dmitryshagin/flashlight/drawings/c_1/page1.png

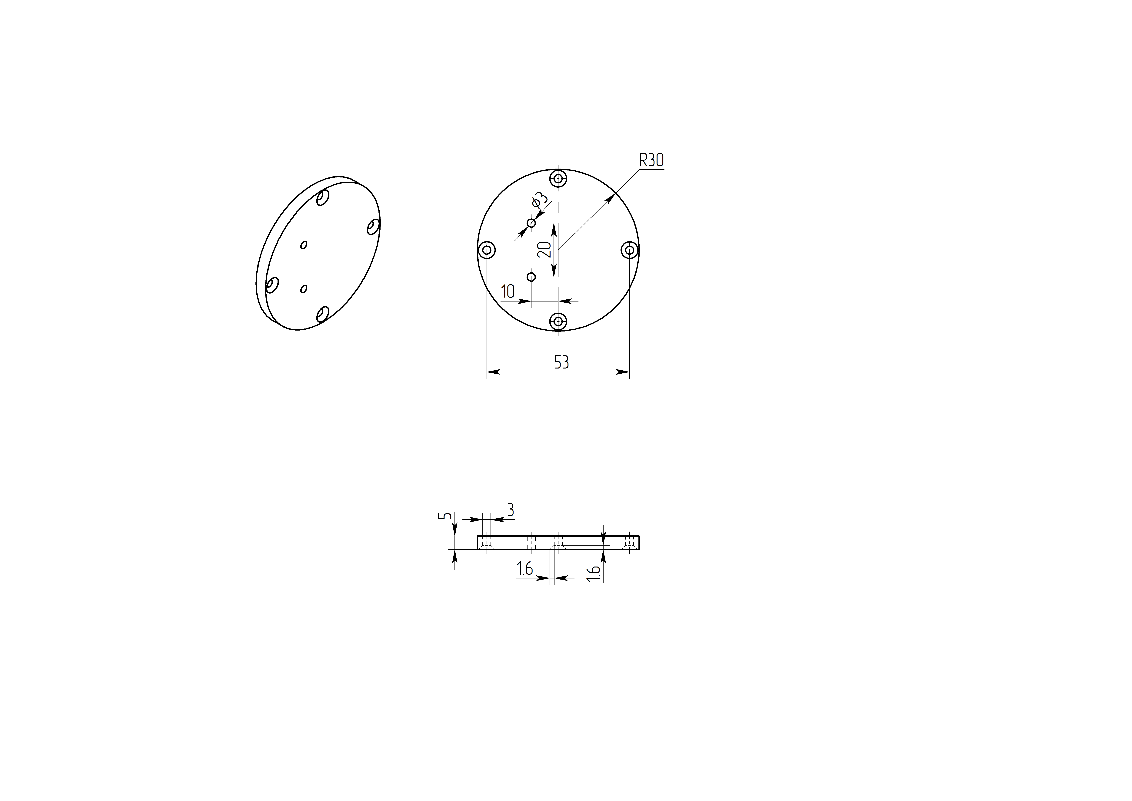
drawings/c_1/page1.png
