dmitryshagin/flashlight/drawings/c_1/page2.png

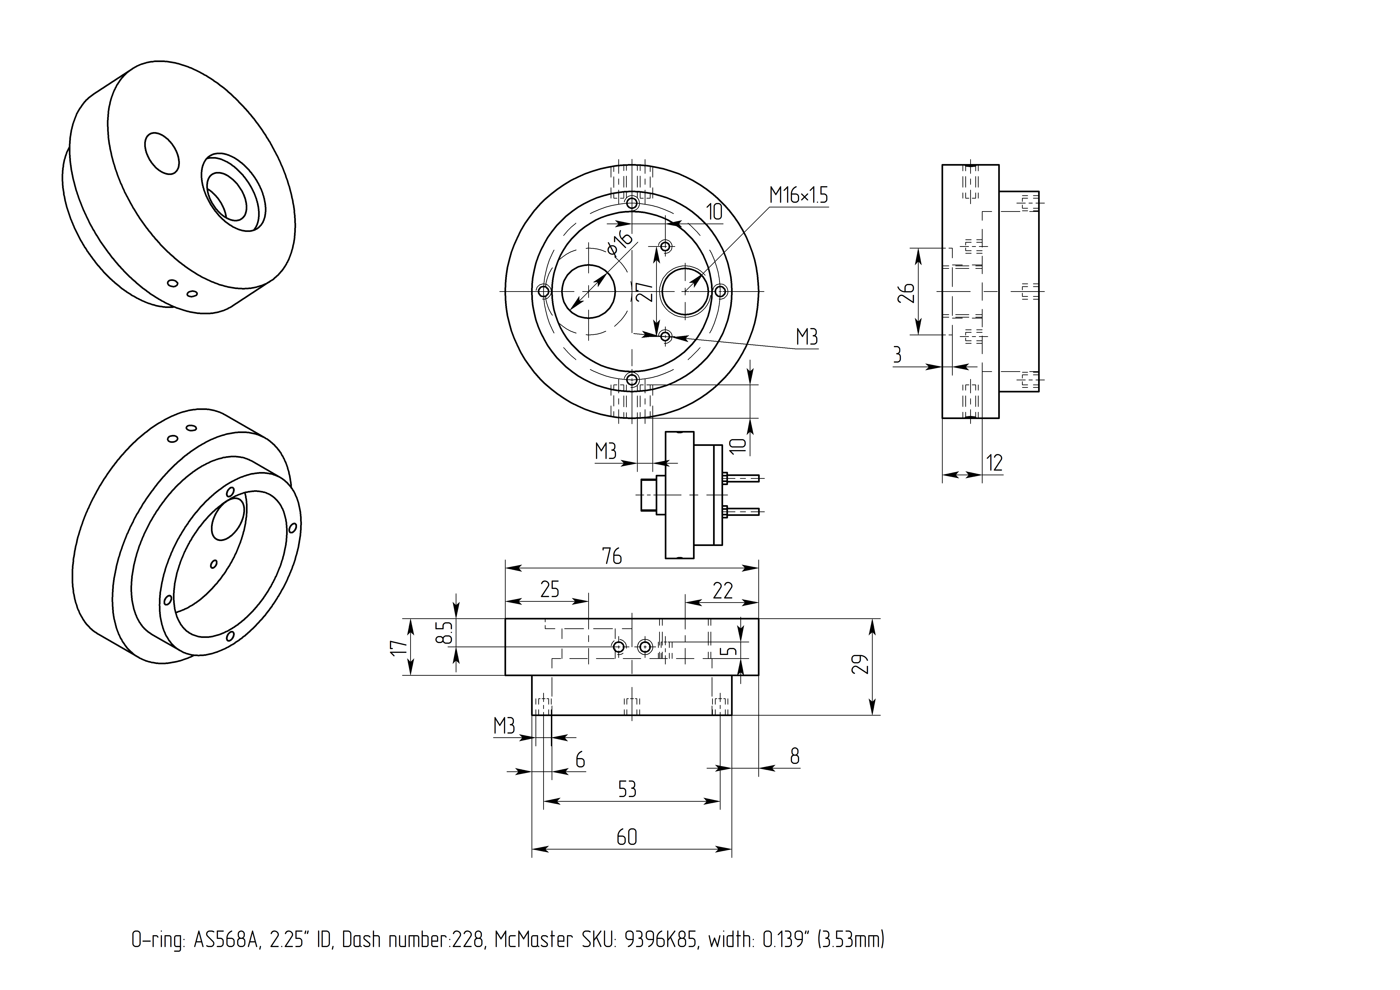
drawings/c_1/page2.png
