dmitryshagin/flashlight/drawings/c_1/page3.png

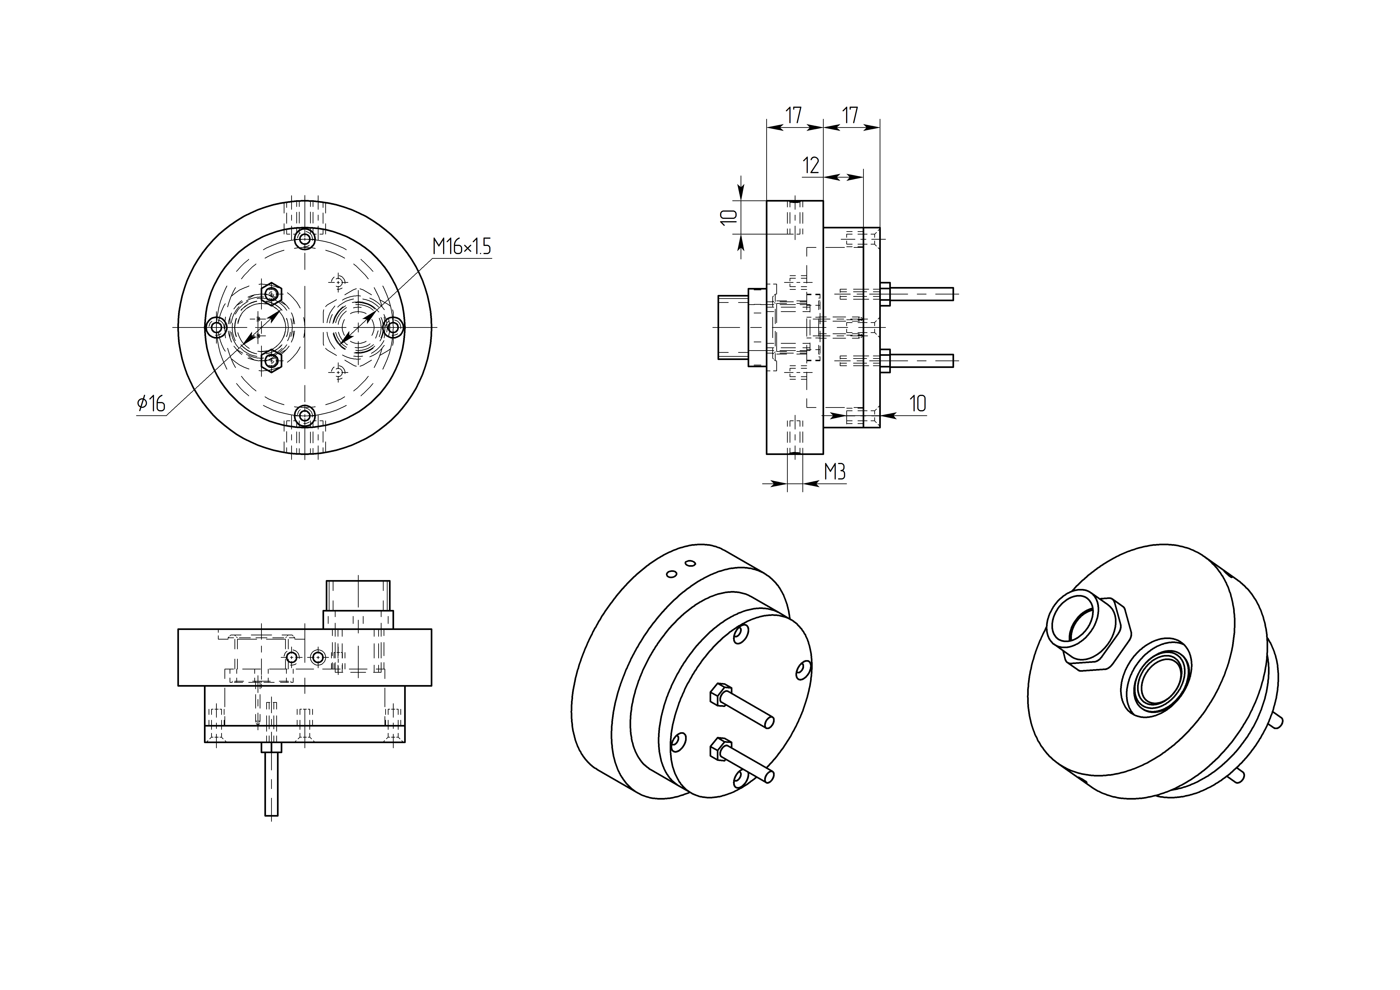
drawings/c_1/page3.png
