dmitryshagin/flashlight/drawings/c_1/page4.png

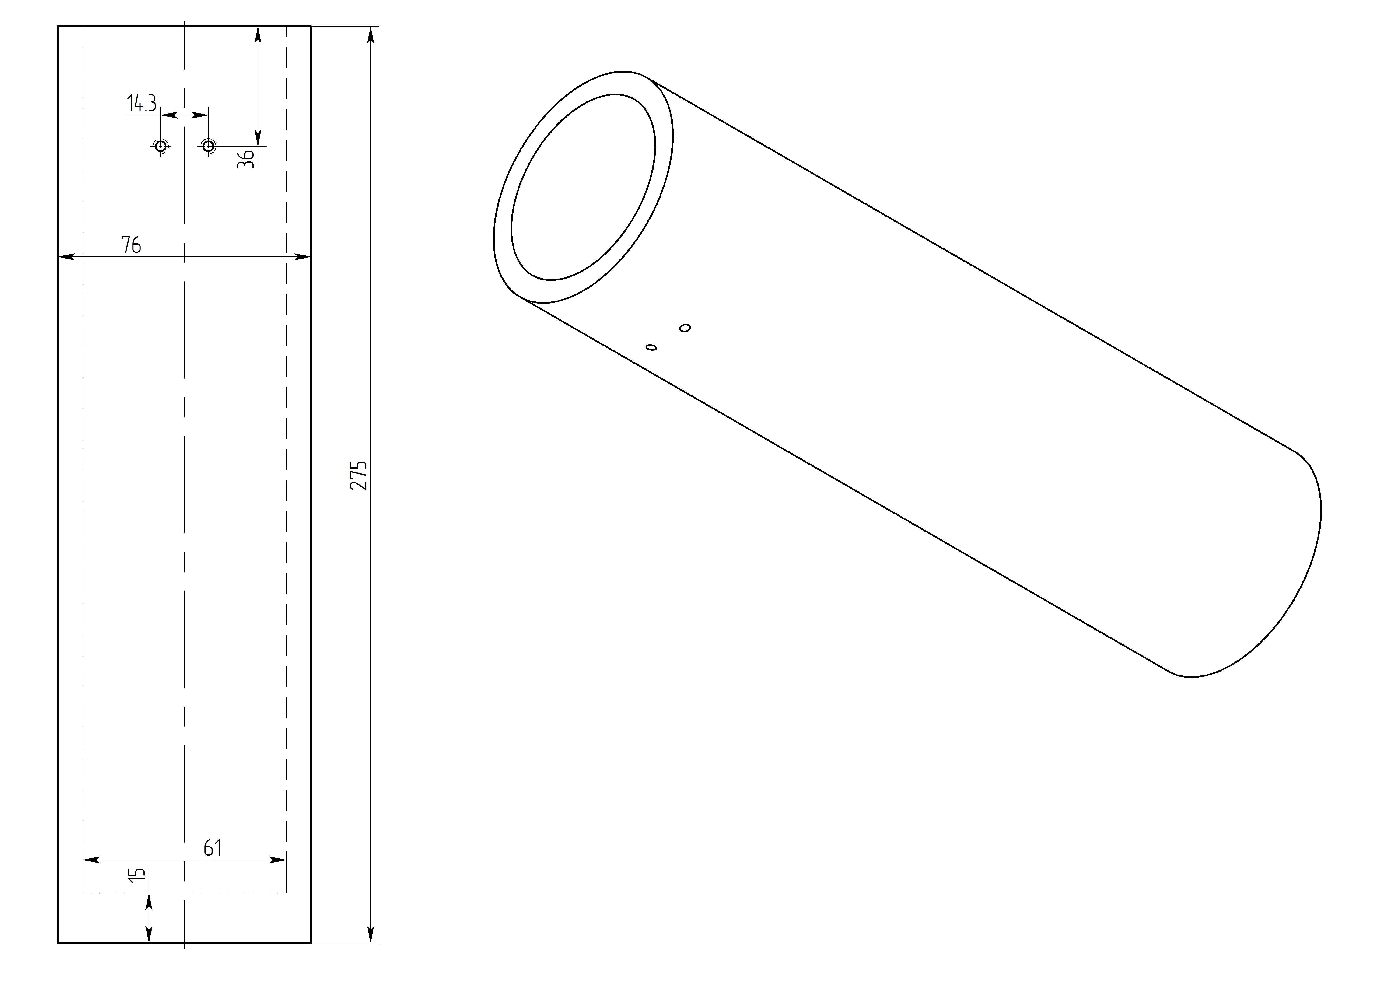
drawings/c_1/page4.png
