dmitryshagin/flashlight/drawings/c_1/page5.png

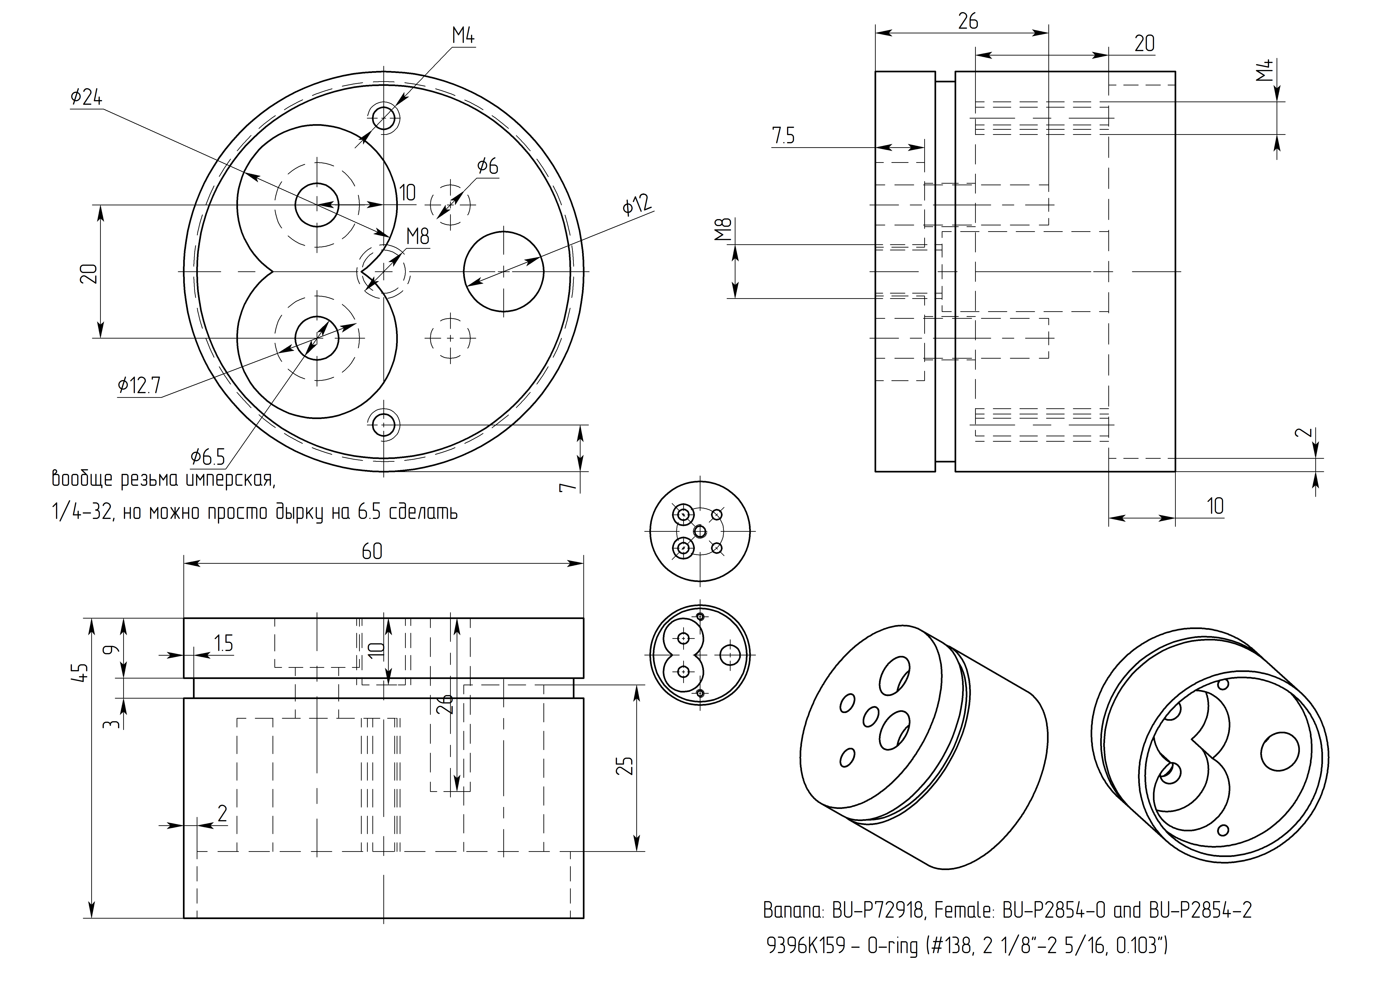
drawings/c_1/page5.png
