dmitryshagin/flashlight/drawings/c_1/page6.png

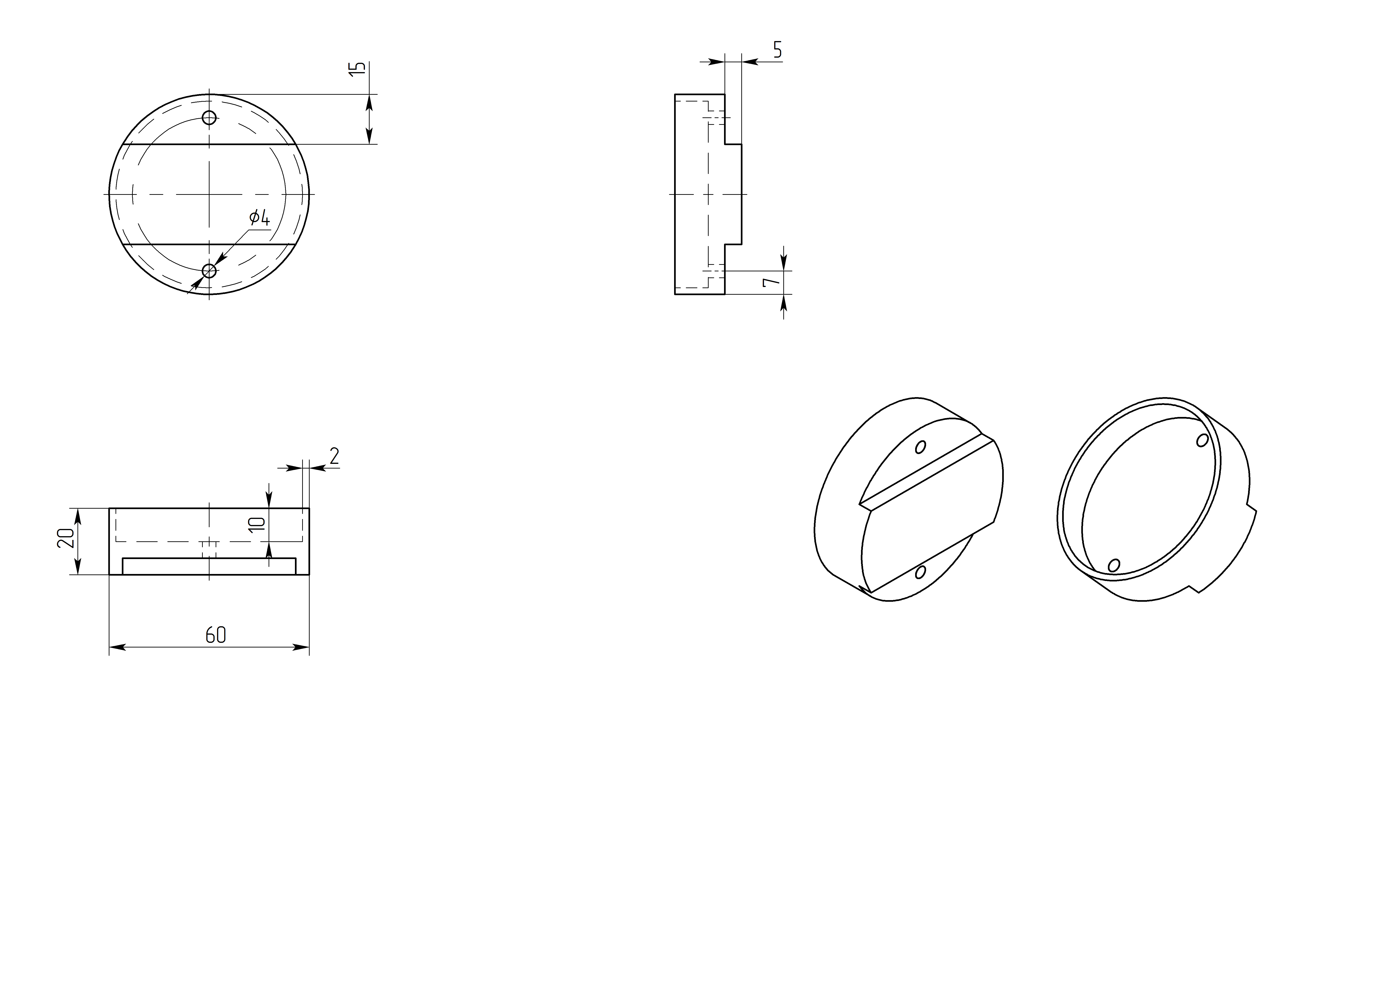
drawings/c_1/page6.png
