dmitryshagin/flashlight/drawings/c_1/page7.png

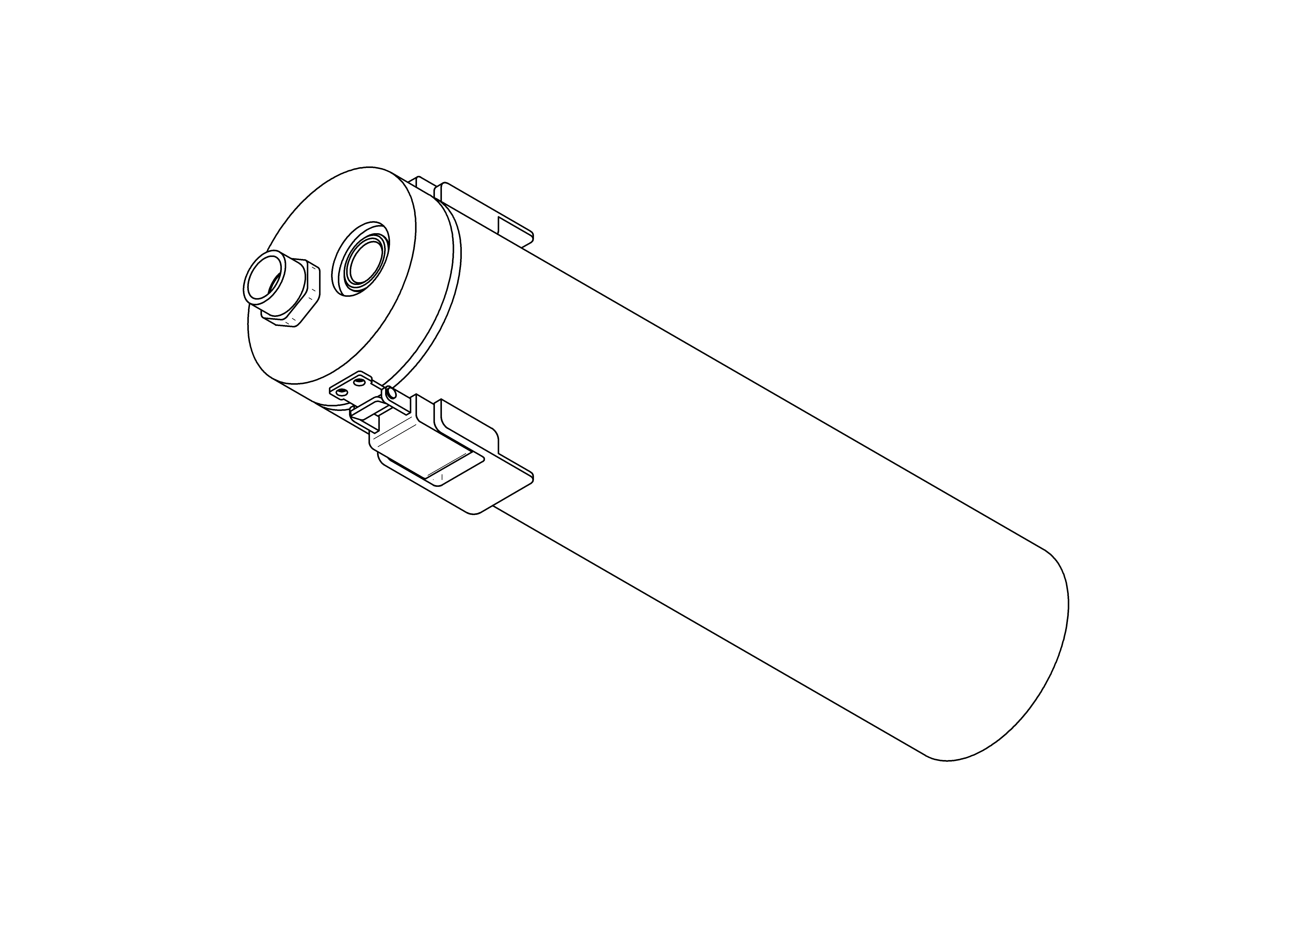
drawings/c_1/page7.png
