dmitryshagin/flashlight/drawings/c_1/page8.png

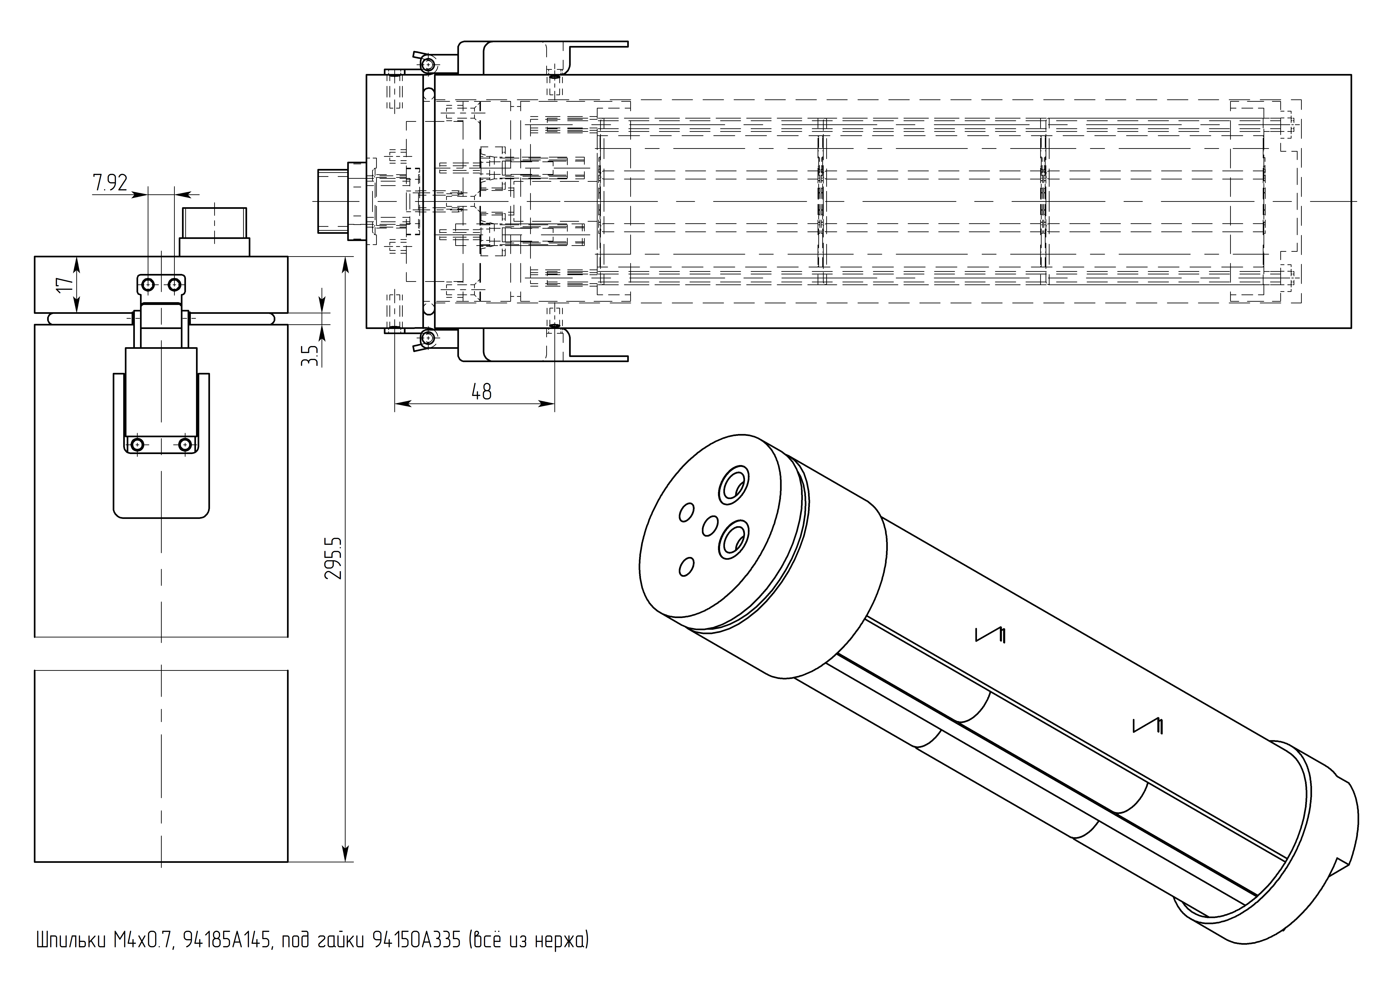
drawings/c_1/page8.png
