dmitryshagin/flashlight/drawings/c_1/page9.png

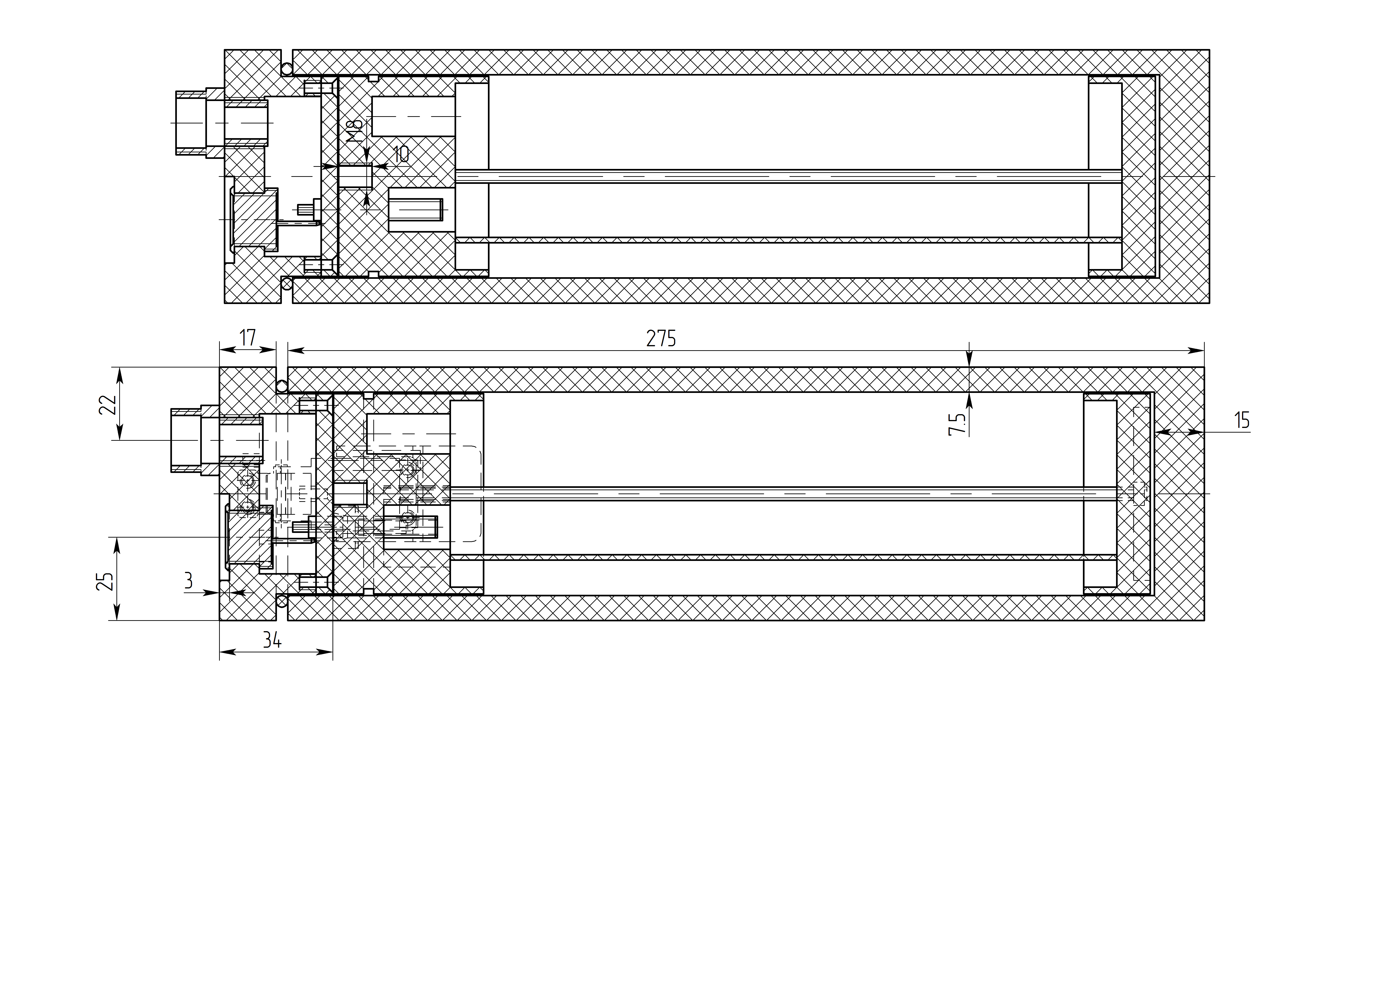
drawings/c_1/page9.png
