dmitryshagin/flashlight/drawings/v_1_2/page1.png

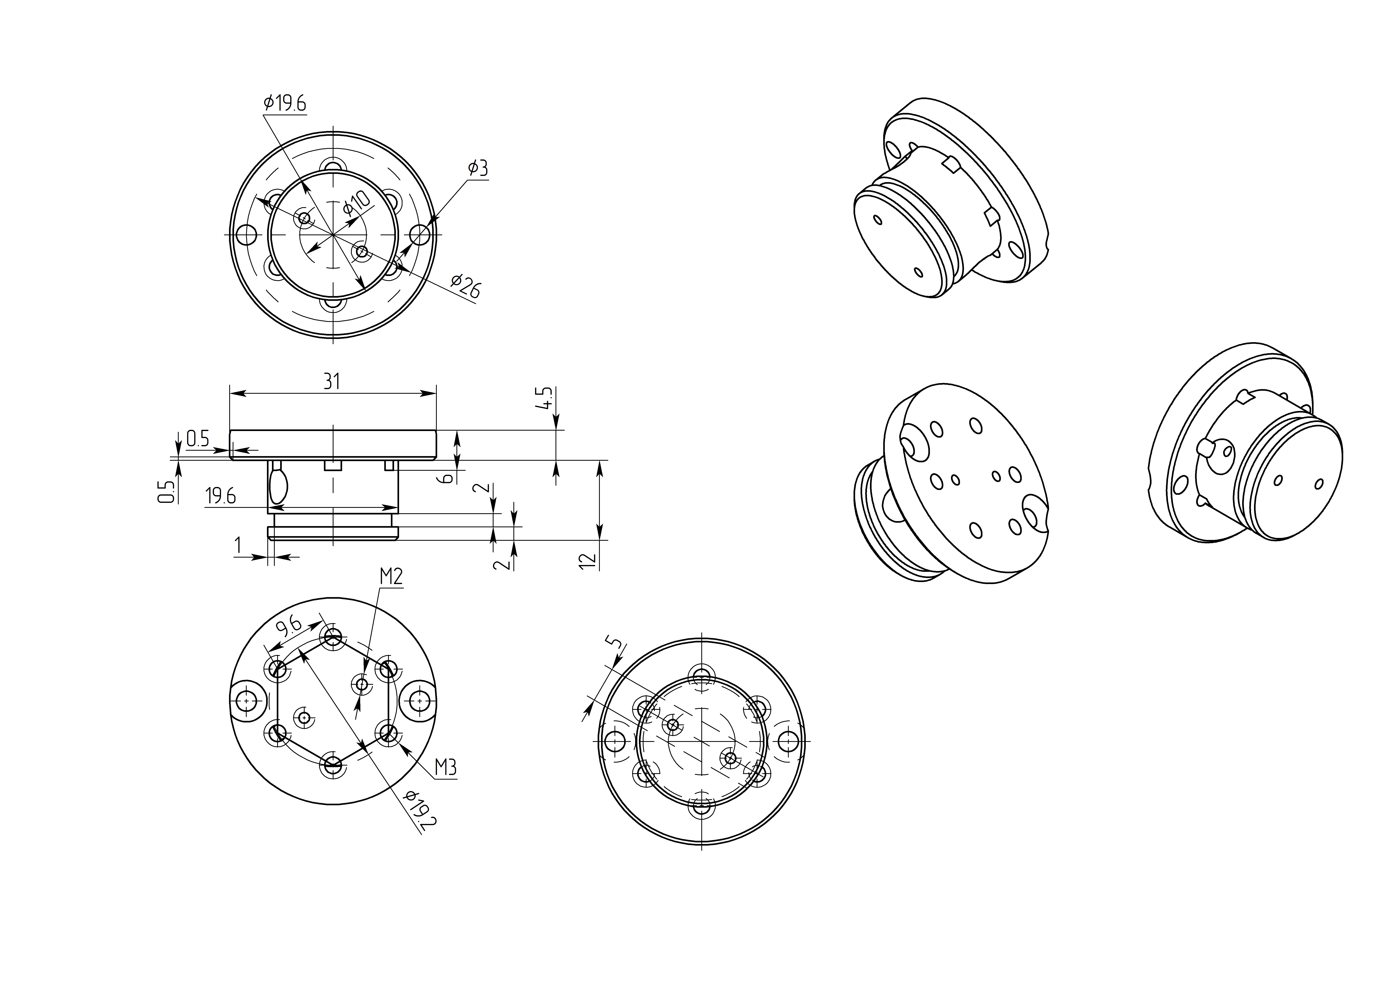
drawings/v_1_2/page1.png
