dmitryshagin/flashlight/drawings/v_1_2/page4.png

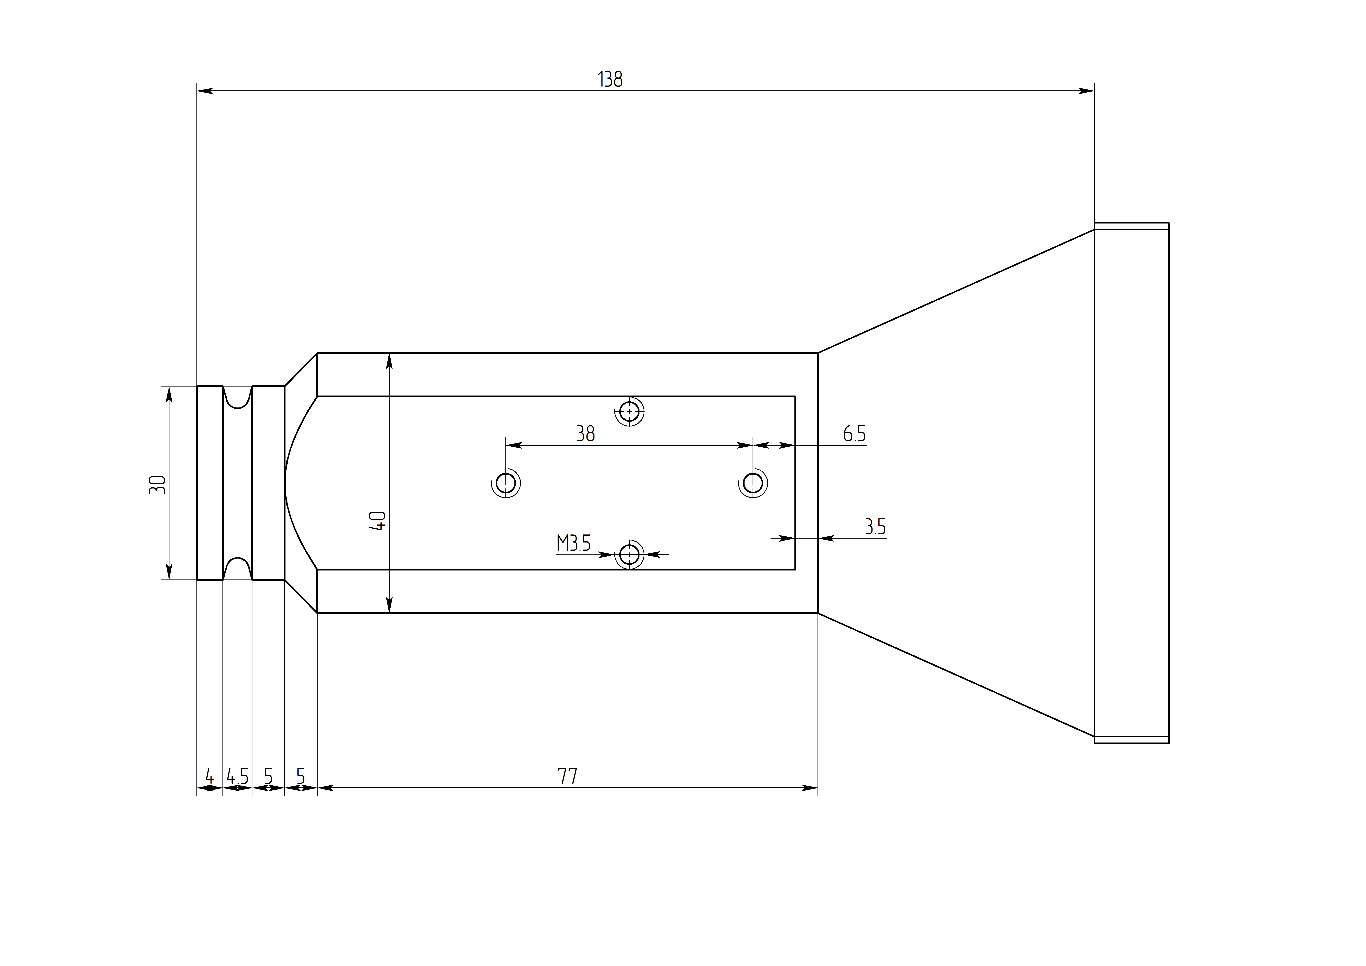
drawings/v_1_2/page4.png
