dmitryshagin/flashlight/drawings/v_1_2/page5.png

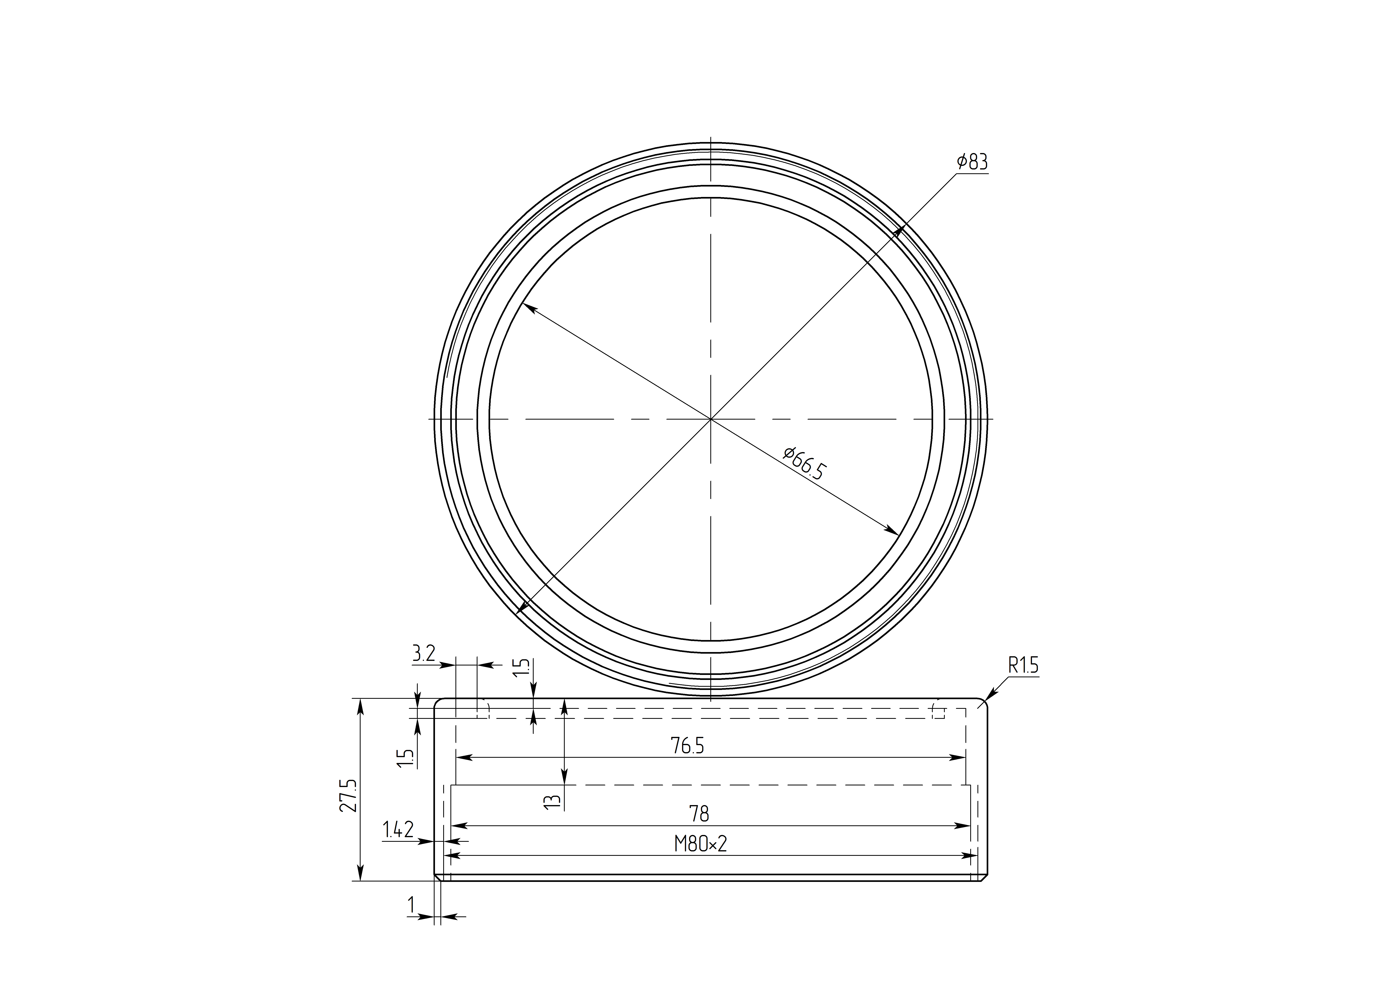
drawings/v_1_2/page5.png
