dmitryshagin/flashlight/drawings/v_1_2/page6.png

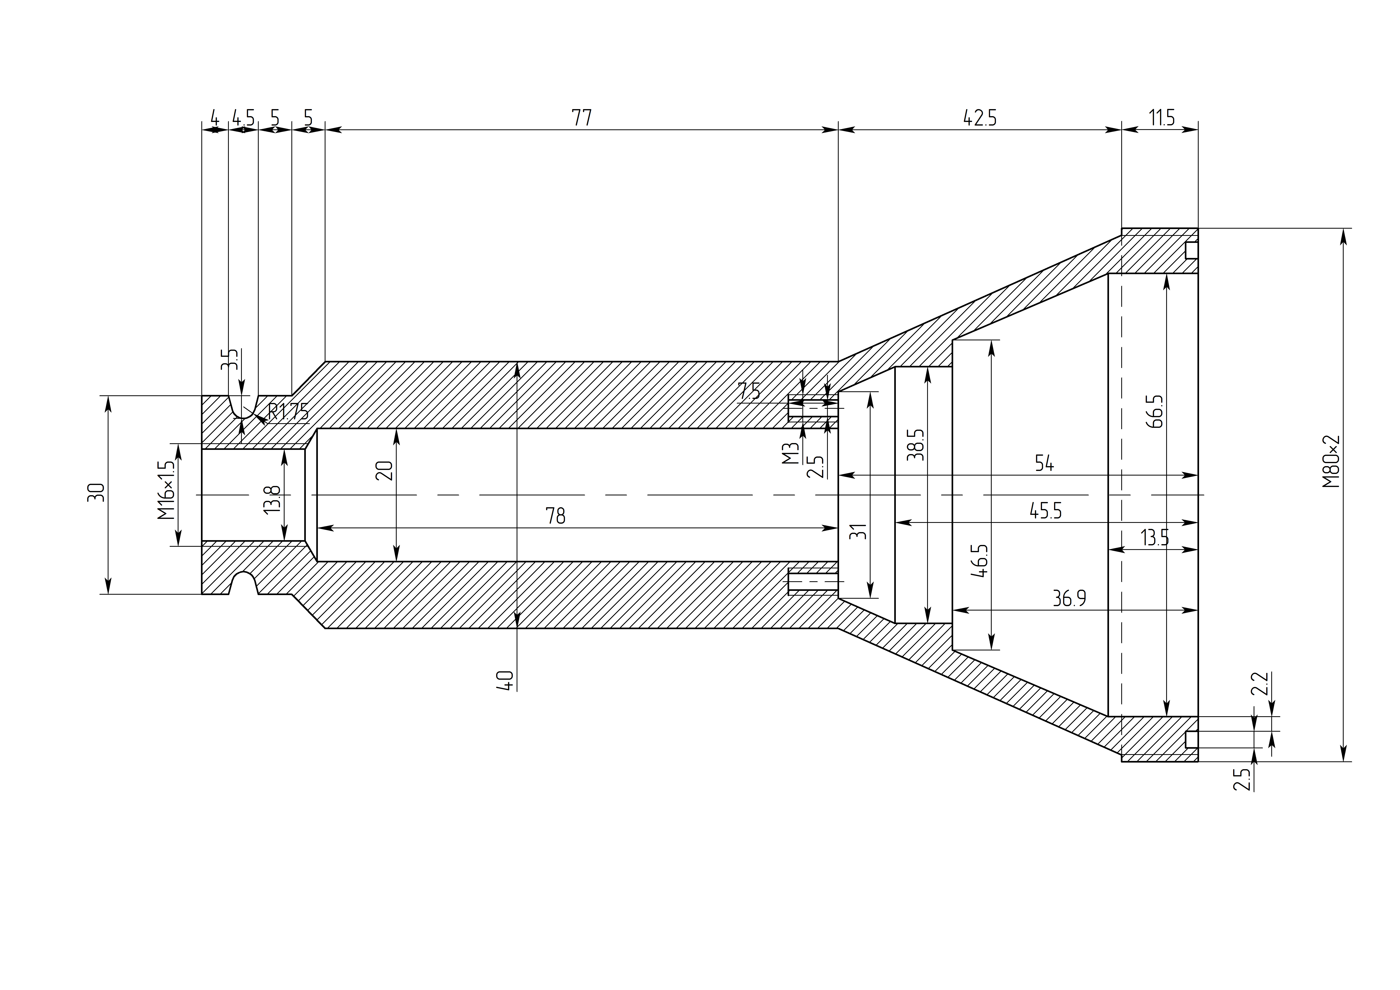
drawings/v_1_2/page6.png
