dmitryshagin/flashlight/drawings/v_1_2/page7.png

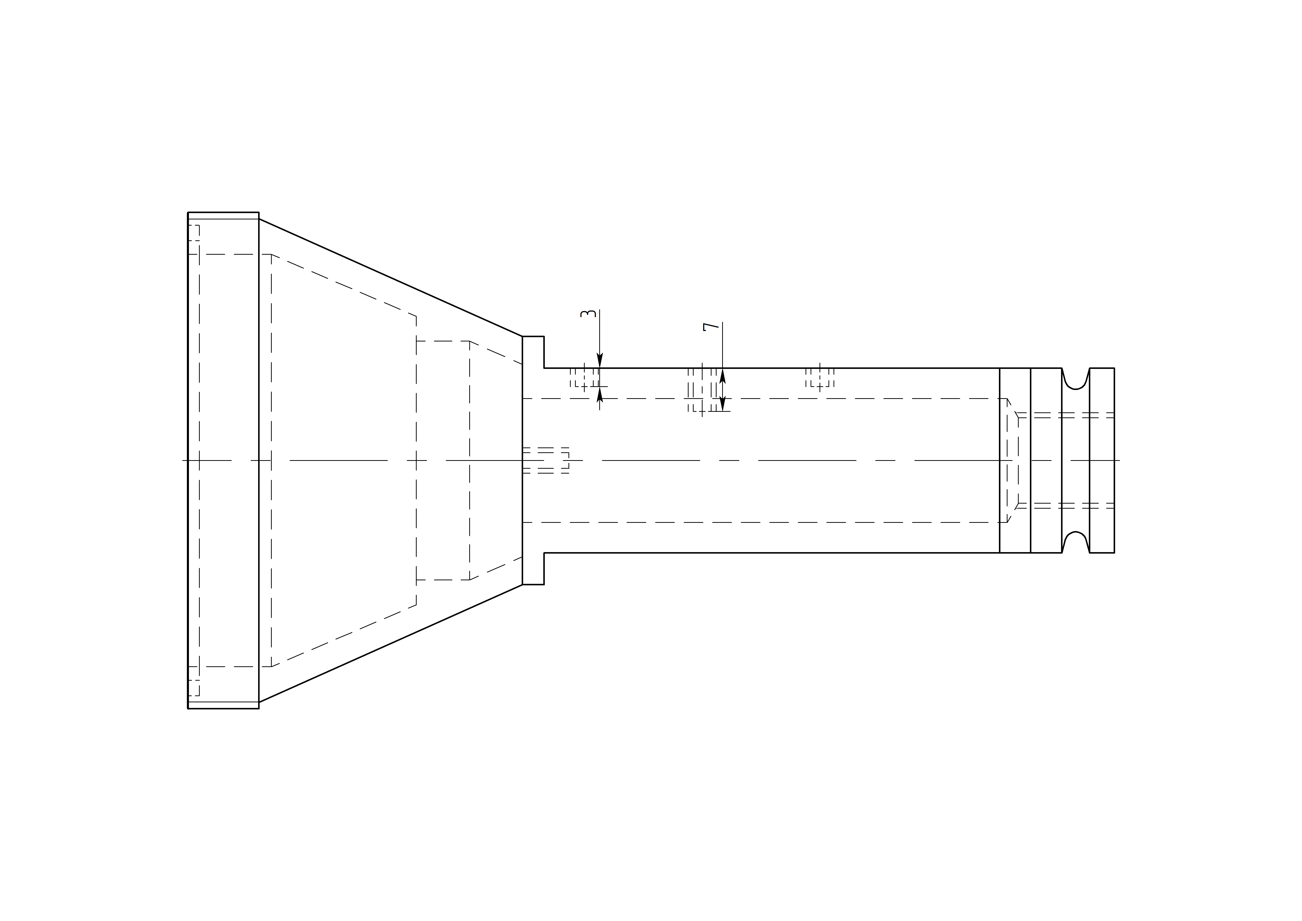
drawings/v_1_2/page7.png
