dmitryshagin/flashlight/drawings/v_1_2/page8.png

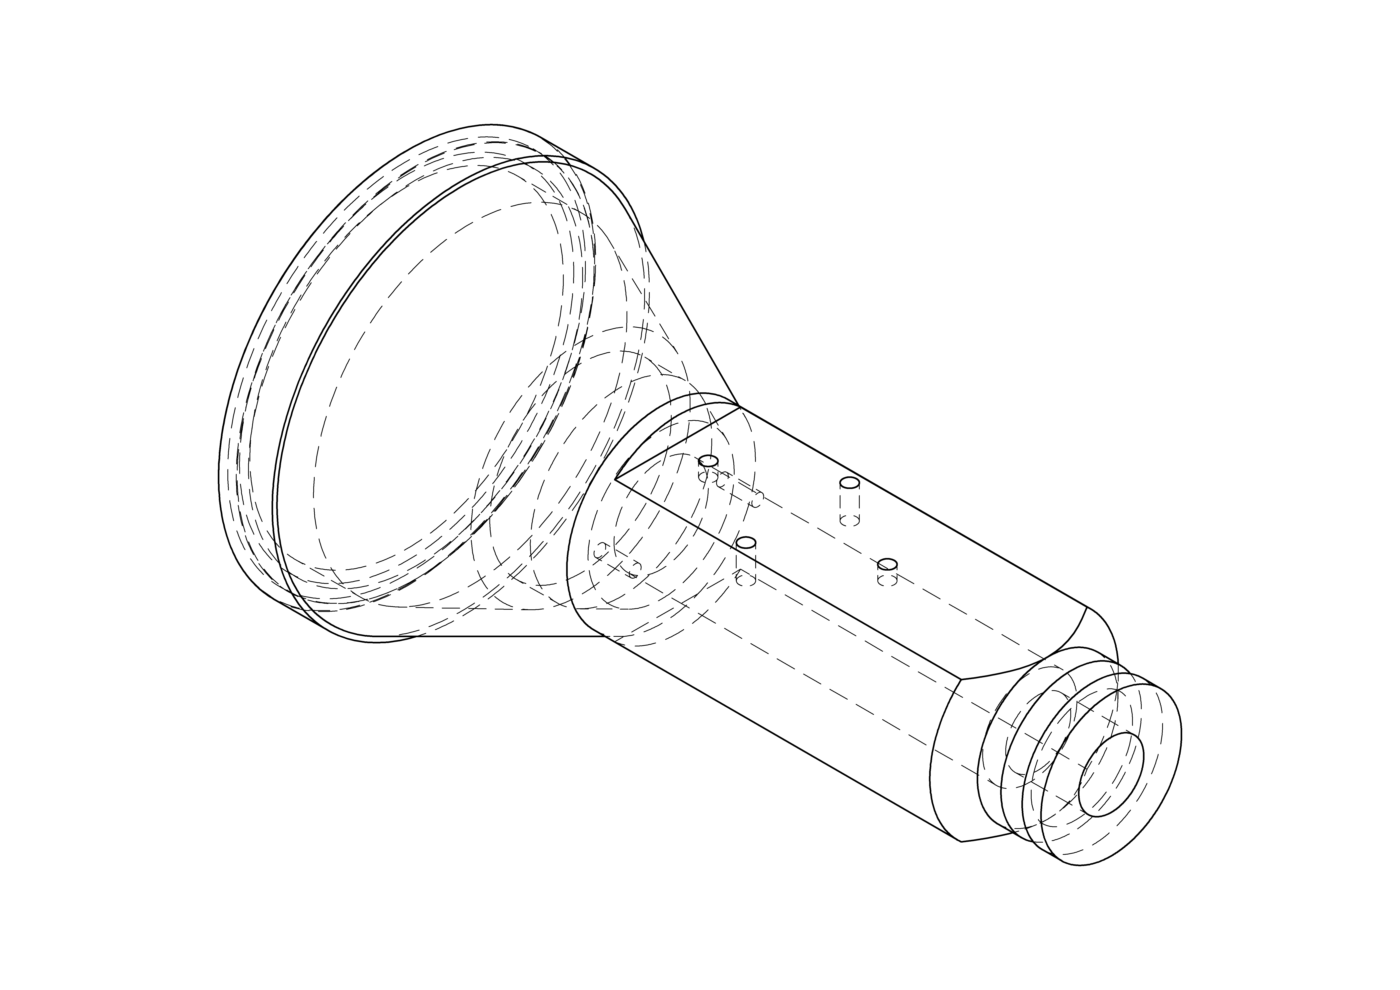
drawings/v_1_2/page8.png
