dmitryshagin/flashlight/drawings/v_1_2/page9.png

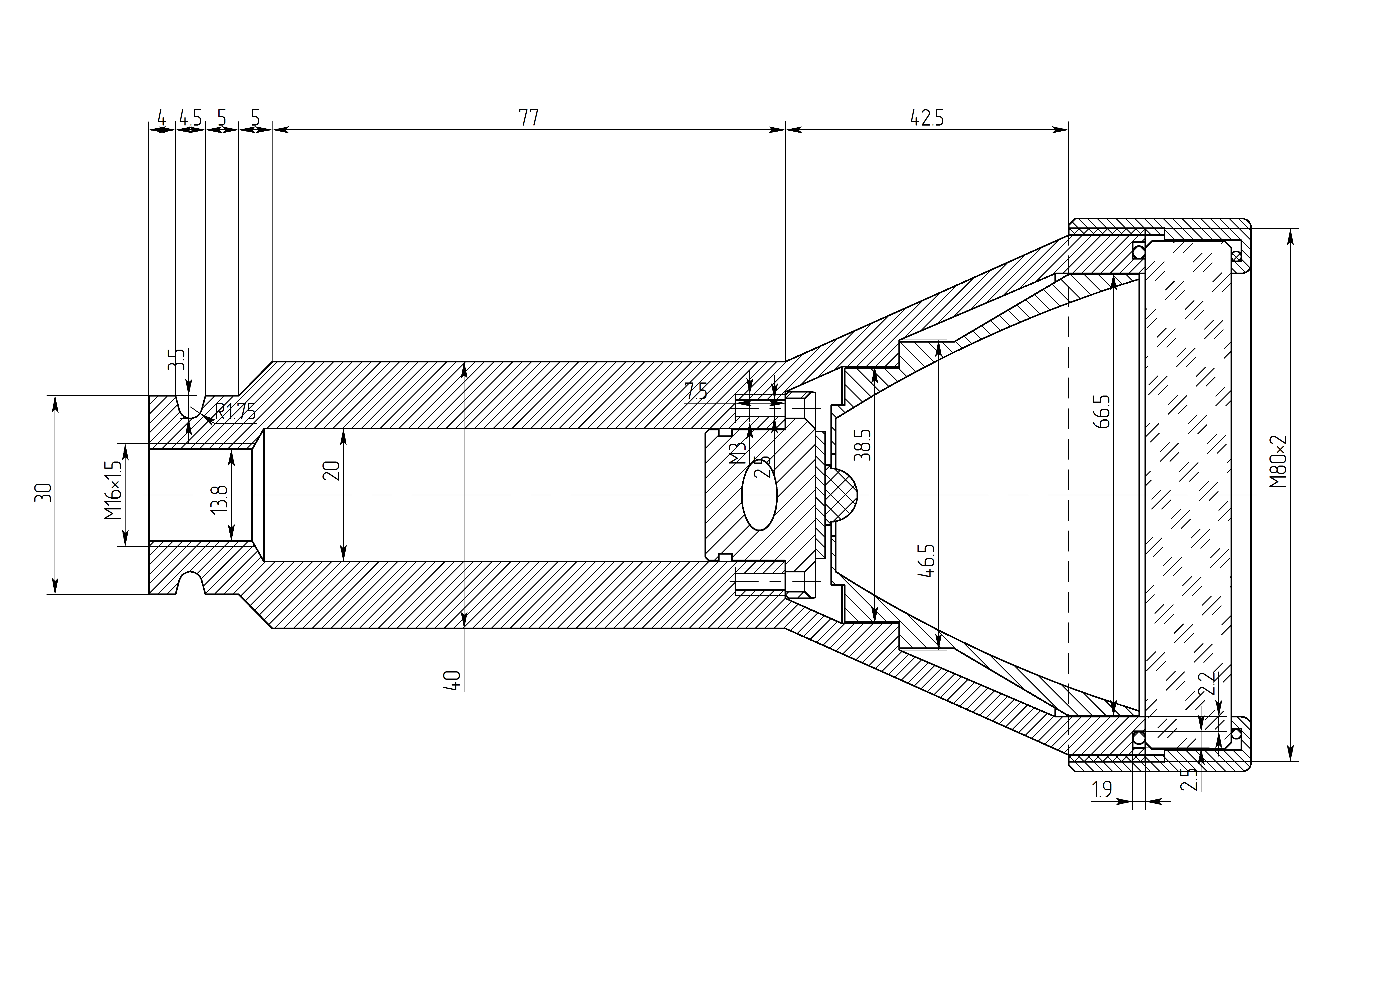
drawings/v_1_2/page9.png
