dmitryshagin/flashlight/drawings/c_1/Сглаживание_1.stl

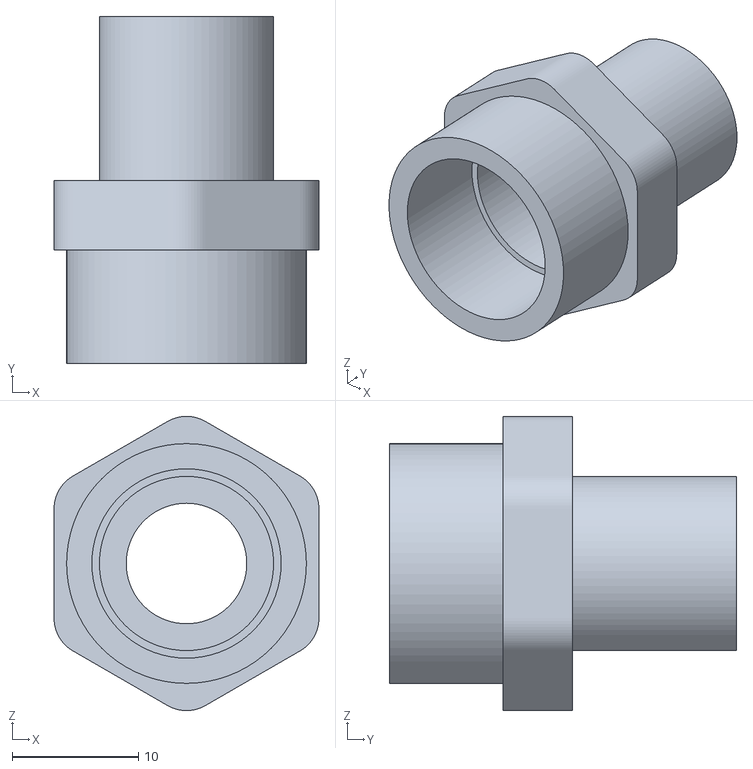
[picture p17: CAD file, 2018-02-22]
drawings/c_1/Сглаживание_1.stl
21.0 x 27.5 x 23.3
