dmitryshagin/flashlight/(list of files, cad)

Other CAD files:
Head.3dm
drawings/c_1/Сглаживание_1.x_t
