dmitryshagin/flashlight/LT3763_TA01_2led.asc

C1: cap; .01µ
C3: cap; 33n
C4: cap; 2.2µ; V=10 Irms=0 Rser=0.002 Lser=0 mfg="TDK" pn="C2012X5RIA225K" type="X5R"
C6: cap; 10µ; V=25 Irms=0 Rser=0.001 Lser=0 mfg="TDK" pn="C575OX7RIE106M" type="X7R"
C7: cap; 4.7µ; V=10 Irms=0 Rser=0.003 Lser=0 mfg="TDK" pn="C3216X5RlA475M" type="X5R"
C8: cap; .22µ
C9: cap; 4.7n
C10: polcap; 220µ; x2; V=10 Irms=6.5 Rser=0.006 Lser=0 mfg="KEMET" pn="T530D227M010ASE006" type="Tantalum"
C11: cap; 1µ; V=25 Irms=0 Rser=0.007 Lser=0 mfg="TDK" pn="C3216X7RIE105M" type="X7R"
D1: schottky; ZLLS2000
D2: LED; PT-121-B
D3: LED; PT-121-B
L1: ind; 2µ; Ipk=24 Rser=0.0028 Rpar=0 Cpar=0 mfg="Pulse" pn="PG0077.202"
Q1: nmos; BSZ0901NSI
Q2: nmos; BSZ0904NSI
R1: res; 82K
R2: res; 10
R3: res; 10
R5: res; 54.9K
R6: res; 110K
R9: res; 15m
R10: res; 54.9K
R11: res; 10K
R13: res; 54.9K
U1: LT3763
V2: voltage; 15
Named nets: 0, IN, OUT
.tran 0 10m 0.1m steady nodiscard uic
LT3763 10W  Single LED Driver
Input: 5V to 20V    Outputs: Cree XM-L2
