dmitryshagin/flashlight/(list of files, drawings)

Other design files:
button_control/control.dsn
driver/led_driver_3A.dsn
driver/led_driver_3A_flat.dsn
