dmitryshagin/flashlight/button_control_esp32/button_control_esp32.brd

## EAGLE design button_control_esp32/button_control_esp32.brd (2019-01-24)

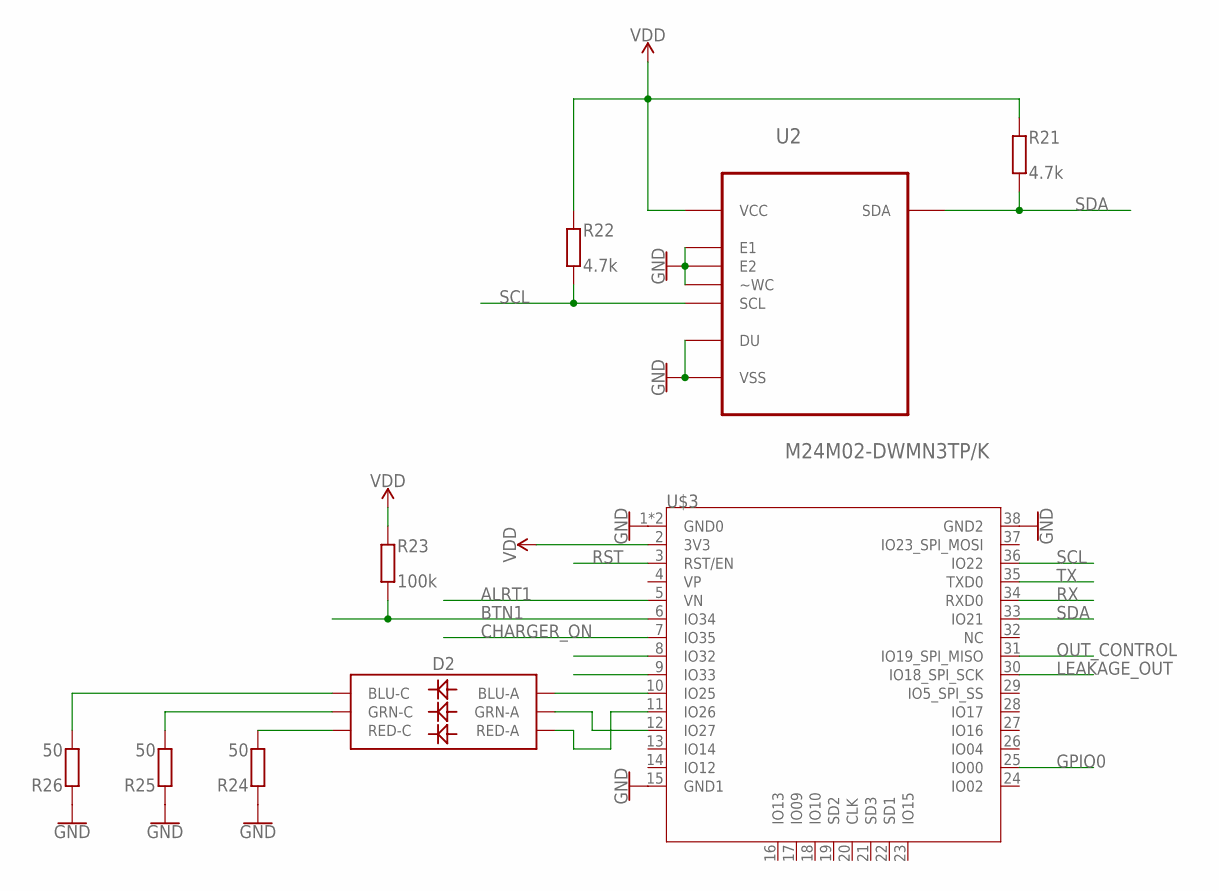
[picture p18: schematic button_control_esp32.sch, sheet 1]

Parts:
D2: LED-RGBNO_IC; LED-TRICOLOR-5050
R21, R22: 4.7k; R0603
R23: 100k; R0603
R24, R25, R26: 50; R0603
U2: M24M02-DWMN3TP/K; SOIC127P600X175-8N
U$3: ESP32; TTGO_ESP32

Connections:
ALRT1: U$3.5 (VN); also elsewhere on the board
BTN1: R23.1, U$3.6 (IO34); also elsewhere on the board
CHARGER_ON: U$3.7 (IO35); also elsewhere on the board
GND: R24.2, R25.2, R26.2, U2.1 (DU), U2.2 (E1), U2.3 (E2), U2.4 (VSS), U2.7 (~WC), U$3.1 (GND0), U$3.15 (GND1), U$3.38 (GND2), U$3.P$1 (GND0); also elsewhere on the board
GPIO0: U$3.25 (IO00); also elsewhere on the board
LEAKAGE_OUT: U$3.30 (IO18_SPI_SCK); also elsewhere on the board
unnamed: D2.3 (BLU-A), U$3.10 (IO25)
unnamed: D2.1 (GRN-A), U$3.12 (IO27)
unnamed: D2.2 (RED-A), U$3.11 (IO26)
unnamed: D2.4 (BLU-C), R26.1
unnamed: D2.6 (GRN-C), R25.1
unnamed: D2.5 (RED-C), R24.1
OUT_CONTROL: U$3.31 (IO19_SPI_MISO); also elsewhere on the board
RST: U$3.3 (RST/EN); also elsewhere on the board
RX: U$3.34 (RXD0); also elsewhere on the board
SCL: R22.1, U2.6 (SCL), U$3.36 (IO22); also elsewhere on the board
SDA: R21.1, U2.5 (SDA), U$3.33 (IO21); also elsewhere on the board
TX: U$3.35 (TXD0); also elsewhere on the board
VDD: R21.2, R22.2, R23.2, U2.8 (VCC), U$3.2 (3V3); also elsewhere on the board

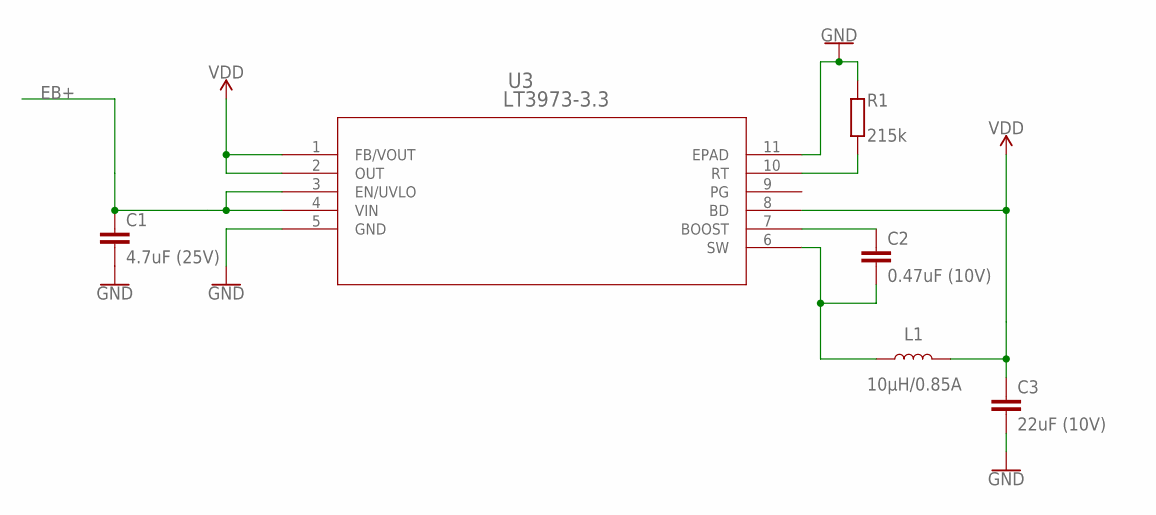
[picture p19: schematic button_control_esp32.sch, sheet 2, POWER]

Parts:
C1: 4.7uF (25V); C1206
C2: 0.47uF (10V); C0603K
C3: 22uF (10V); C1206
L1: 10µH/0.85A; INDUCTOR_4.7UH
R1: 215k; R0603
U3: LT3973-3.3; DFN-10_DD

Connections:
BOOST: C2.1, U3.7 (BOOST)
EB+: C1.1, U3.3 (EN/UVLO), U3.4 (VIN); also elsewhere on the board
GND: C1.2, C3.2, R1.2, U3.5 (GND), U3.11 (EPAD); also elsewhere on the board
RT: R1.1, U3.10 (RT)
SW: C2.2, L1.P$1 (1), U3.6 (SW)
VDD: C3.1, L1.P$2 (2), U3.1 (FB/VOUT), U3.2 (OUT), U3.8 (BD); also elsewhere on the board

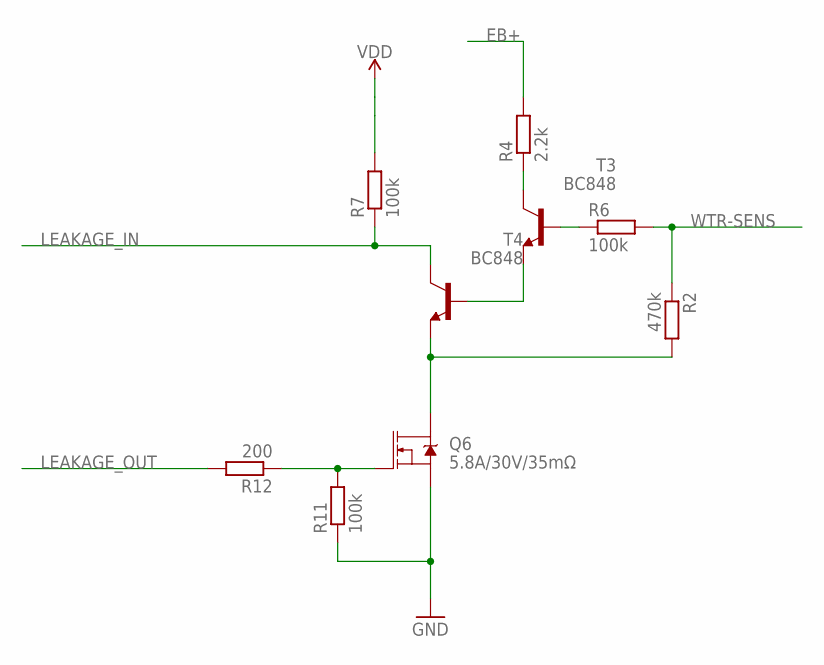
[picture p20: schematic button_control_esp32.sch, sheet 3, LEAKAGE]

Parts:
Q6: 5.8A/30V/35mΩ; SOT23-3
R2: 470k; R0603
R4: 2.2k; R0603
R6, R7, R11: 100k; R0603
R12: 200; R0603
T3, T4: BC848; SOT23

Connections:
EB+: R4.2; also elsewhere on the board
GND: Q6.2 (S), R11.1; also elsewhere on the board
LEAKAGE_IN: R7.1, T4.3 (C)
LEAKAGE_OUT: R12.2; also elsewhere on the board
unnamed: T3.2 (E), T4.1 (B)
unnamed: R6.1, T3.1 (B)
unnamed: Q6.3 (D), R2.2, T4.2 (E)
VDD: R7.2; also elsewhere on the board
WTR-SENS: R2.1, R6.2; also elsewhere on the board
WTR_MEASURE_ON1: Q6.1 (G), R11.2, R12.1
WTR_MEASURE_PULLUP1: R4.1, T3.3 (C)

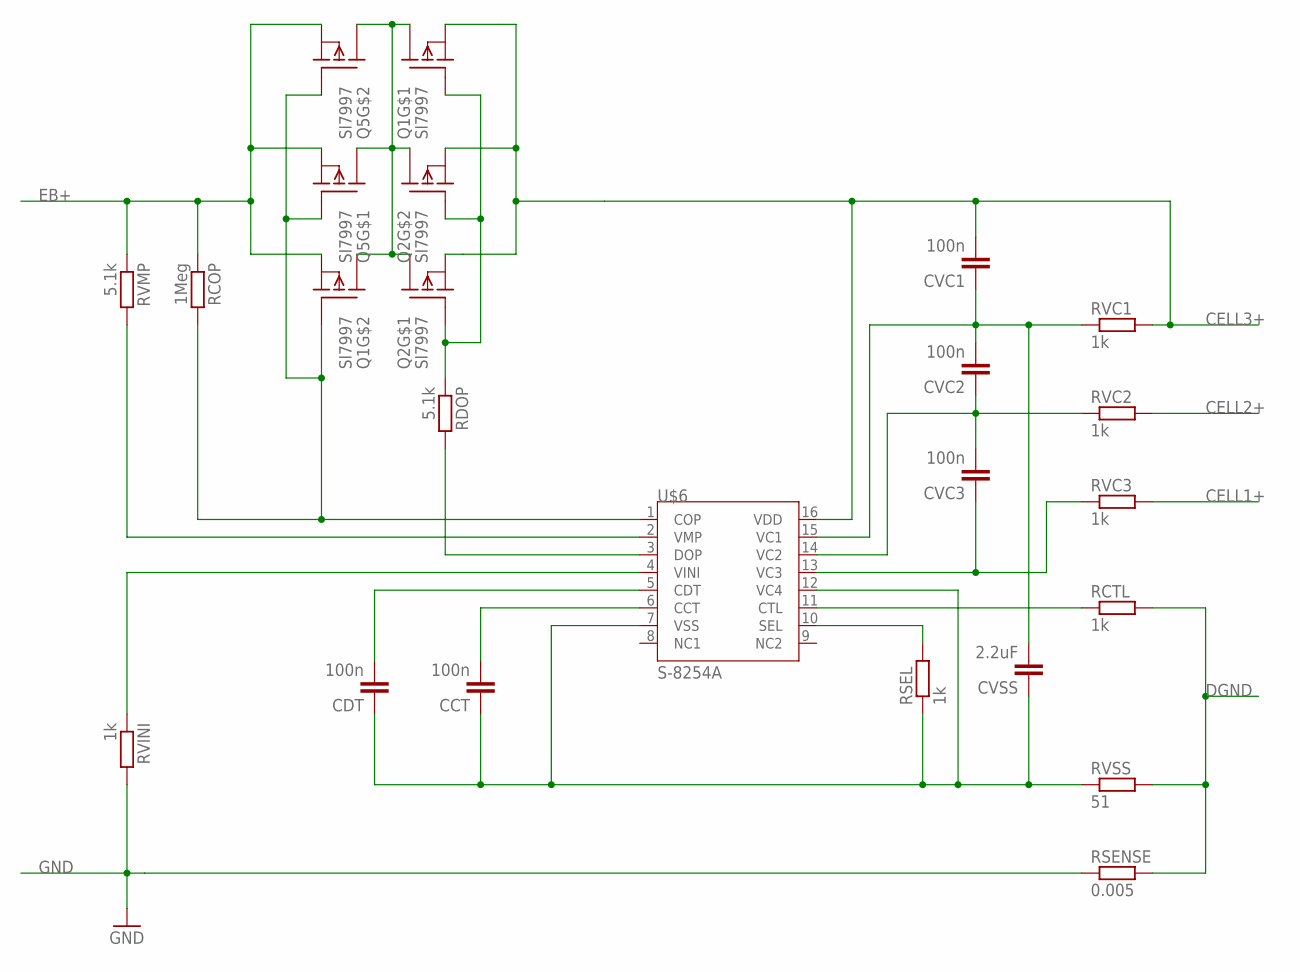
[picture p21: schematic button_control_esp32.sch, sheet 4, BMS]

Parts:
CCT: 100n; C0603
CDT: 100n; C0603
CVC1, CVC3: 100n; C0603
CVC2: 100n; C0805K
CVSS: 2.2uF; C0805
Q1, Q2, Q5: SI7997; POWERPAK
RCOP: 1Meg; R0603
RCTL: 1k; R0603
RDOP: 5.1k; R0603
RSEL: 1k; R0603
RSENSE: 0.005; R2010
RVC1, RVC2, RVC3: 1k; R0603
RVINI: 1k; R0603
RVMP: 5.1k; R0603
RVSS: 51; R0603
U$6: S-8254A; TSSOP-16

Connections:
CELL1+: RVC3.2; also elsewhere on the board
CELL2+: RVC2.2; also elsewhere on the board
CELL3+: CVC1.2, Q1.1 (S), Q2.1 (S), Q2.3 (S), RVC1.2, U$6.16 (VDD); also elsewhere on the board
DGND: RCTL.2, RSENSE.2, RVSS.2; also elsewhere on the board
EB+: Q1.3 (S), Q5.1 (S), Q5.3 (S), RCOP.1, RVMP.1; also elsewhere on the board
GND: RSENSE.1, RVINI.2; also elsewhere on the board
unnamed: RDOP.2, U$6.3 (DOP)
unnamed: Q1.4 (G), Q5.2 (G), Q5.4 (G), RCOP.2, U$6.1 (COP)
unnamed: Q1.2 (G), Q2.2 (G), Q2.4 (G), RDOP.1
unnamed: RVMP.2, U$6.2 (VMP)
unnamed: RSEL.2, U$6.10 (SEL)
unnamed: RVINI.1, U$6.4 (VINI)
unnamed: CDT.2, U$6.5 (CDT)
unnamed: CCT.2, U$6.6 (CCT)
unnamed: CCT.1, CDT.1, CVSS.1, RSEL.1, RVSS.1, U$6.7 (VSS), U$6.12 (VC4)
unnamed: RCTL.1, U$6.11 (CTL)
unnamed: Q1.5 (D), Q1.5_6 (D), Q1.6 (D), Q1.7 (D), Q1.7_8 (D), Q1.8 (D), Q2.5 (D), Q2.5_6 (D), Q2.6 (D), Q2.7 (D), Q2.7_8 (D), Q2.8 (D), Q5.5 (D), Q5.5_6 (D), Q5.6 (D), Q5.7 (D), Q5.7_8 (D), Q5.8 (D)
unnamed: CVC3.1, RVC3.1, U$6.13 (VC3)
unnamed: CVC2.1, CVC3.2, RVC2.1, U$6.14 (VC2)
unnamed: CVC1.1, CVC2.2, CVSS.2, RVC1.1, U$6.15 (VC1)

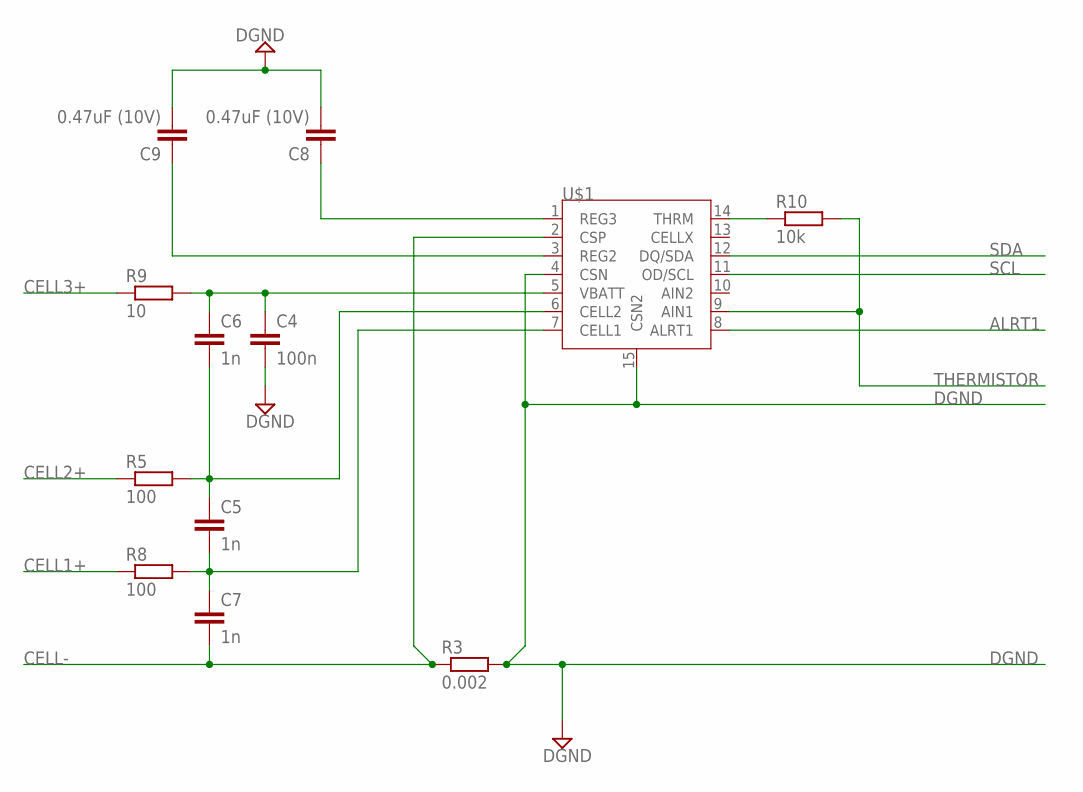
[picture p22: schematic button_control_esp32.sch, sheet 5, GAUGE]

Parts:
C4: 100n; C0603
C5, C6, C7: 1n; C0603
C8, C9: 0.47uF (10V); C0603K
R3: 0.002; R2010
R5, R8: 100; R0805
R9: 10; R0603
R10: 10k; R0603
U$1: MAX17205G; SON40P300X300X80-15N230X170

Connections:
ALRT1: U$1.8 (ALRT1); also elsewhere on the board
CELL1+: R8.1; also elsewhere on the board
CELL2+: R5.1; also elsewhere on the board
CELL3+: R9.1; also elsewhere on the board
CELL-: C7.2, R3.1, U$1.2 (CSP); also elsewhere on the board
DGND: C4.2, C8.2, C9.2, R3.2, U$1.4 (CSN), U$1.15 (CSN2); also elsewhere on the board
unnamed: C4.1, C6.1, R9.2, U$1.5 (VBATT)
unnamed: C5.1, C6.2, R5.2, U$1.6 (CELL2)
unnamed: C5.2, C7.1, R8.2, U$1.7 (CELL1)
unnamed: R10.1, U$1.14 (THRM)
unnamed: C8.1, U$1.1 (REG3)
unnamed: C9.1, U$1.3 (REG2)
SCL: U$1.11 (OD/SCL); also elsewhere on the board
SDA: U$1.12 (DQ/SDA); also elsewhere on the board
THERMISTOR: R10.2, U$1.9 (AIN1); also elsewhere on the board

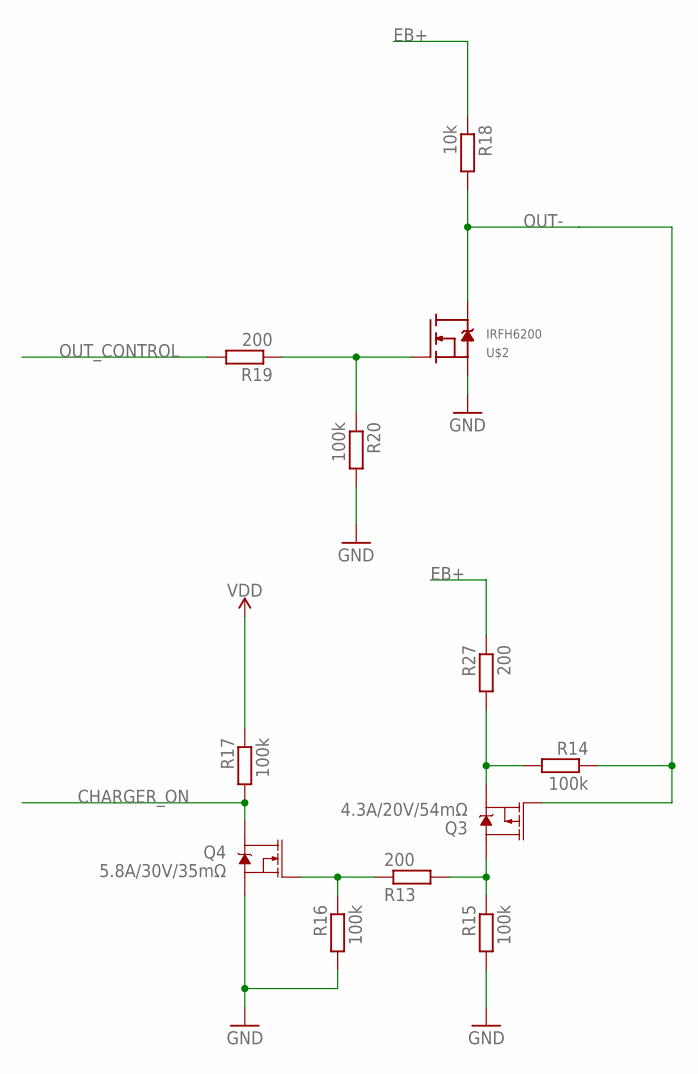
[picture p23: schematic button_control_esp32.sch, sheet 6, SWITCH]

Parts:
Q3: 4.3A/20V/54mΩ; SOT23-3
Q4: 5.8A/30V/35mΩ; SOT23-3
R13, R19, R27: 200; R0603
R14, R15, R16, R17, R20: 100k; R0603
R18: 10k; R0603
U$2: IRFH6200; PQFN

Connections:
CHARGER_ON: Q4.3 (D), R17.2; also elsewhere on the board
EB+: R18.1, R27.1; also elsewhere on the board
GND: Q4.2 (S), R15.2, R16.2, R20.2, U$2.1 (S), U$2.2 (S), U$2.3 (S); also elsewhere on the board
unnamed: Q3.3 (D), R13.2, R15.1
unnamed: Q4.1 (G), R13.1, R16.1
unnamed: Q3.2 (S), R14.2, R27.2
OUT-: Q3.1 (G), R14.1, R18.2, U$2.5 (D), U$2.6 (D), U$2.7 (D), U$2.8 (D), U$2.9 (D); also elsewhere on the board
OUT_BASE: R19.1, R20.1, U$2.4 (G)
OUT_CONTROL: R19.2; also elsewhere on the board
VDD: R17.1; also elsewhere on the board

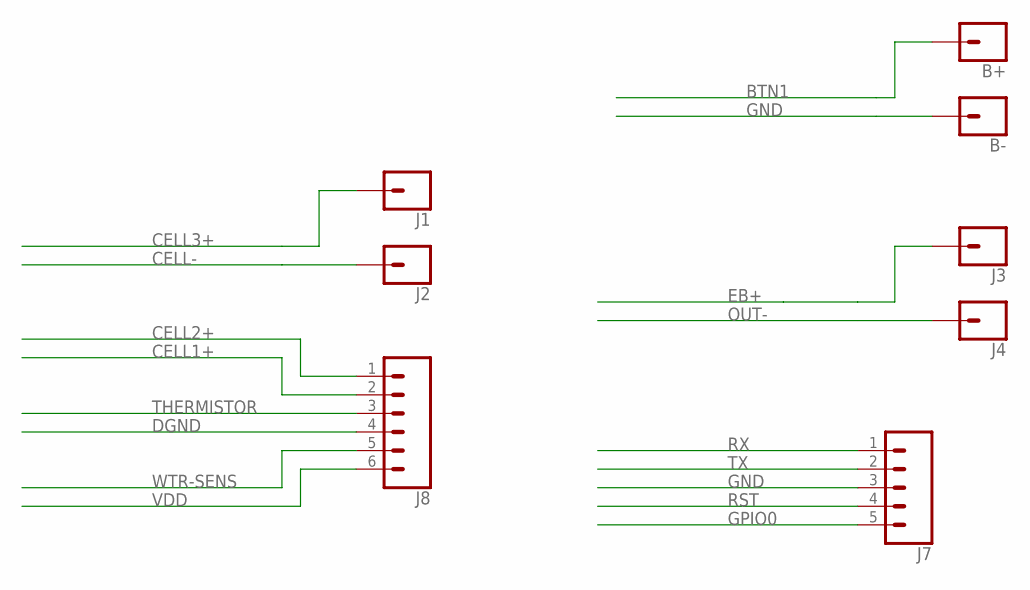
[picture p24: schematic button_control_esp32.sch, sheet 7, CONN]

Parts:
B+: CONN_01; 1X01
B-: CONN_01; 1X01
J1, J2, J3, J4: CONN_01PTH_2MM; 1X01_2MM
J7: CONN_051.27MM; 1X05_1.27MM
J8: CONN_061.27MM; 1X06_1.27MM

Connections:
BTN1: B+.1; also elsewhere on the board
CELL1+: J8.2; also elsewhere on the board
CELL2+: J8.1; also elsewhere on the board
CELL3+: J1.1; also elsewhere on the board
CELL-: J2.1; also elsewhere on the board
DGND: J8.4; also elsewhere on the board
EB+: J3.1; also elsewhere on the board
GND: B-.1, J7.3; also elsewhere on the board
GPIO0: J7.5; also elsewhere on the board
OUT-: J4.1; also elsewhere on the board
RST: J7.4; also elsewhere on the board
RX: J7.1; also elsewhere on the board
THERMISTOR: J8.3; also elsewhere on the board
TX: J7.2; also elsewhere on the board
VDD: J8.6; also elsewhere on the board
WTR-SENS: J8.5; also elsewhere on the board

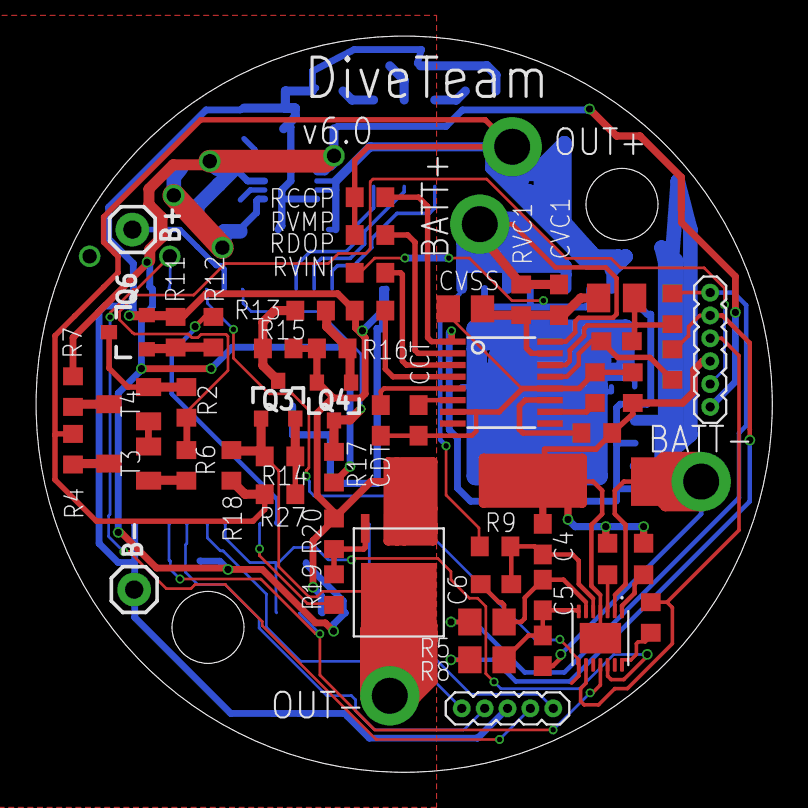
[picture p25: board button_control_esp32.brd from above]

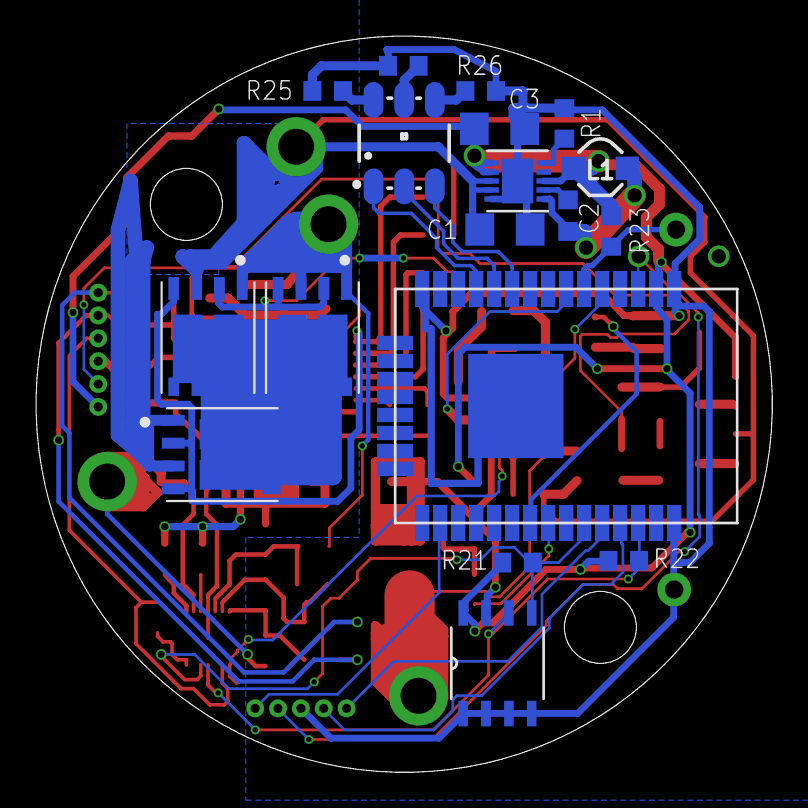
[picture p26: board button_control_esp32.brd from below]

Board: 2 copper layers, 40.9 x 40.9 mm, 77 parts (20 on the bottom side), 61 nets.
