dmitryshagin/flashlight/driver/led_driver_3A.brd

## EAGLE design driver/led_driver_3A.brd (2015-12-27)

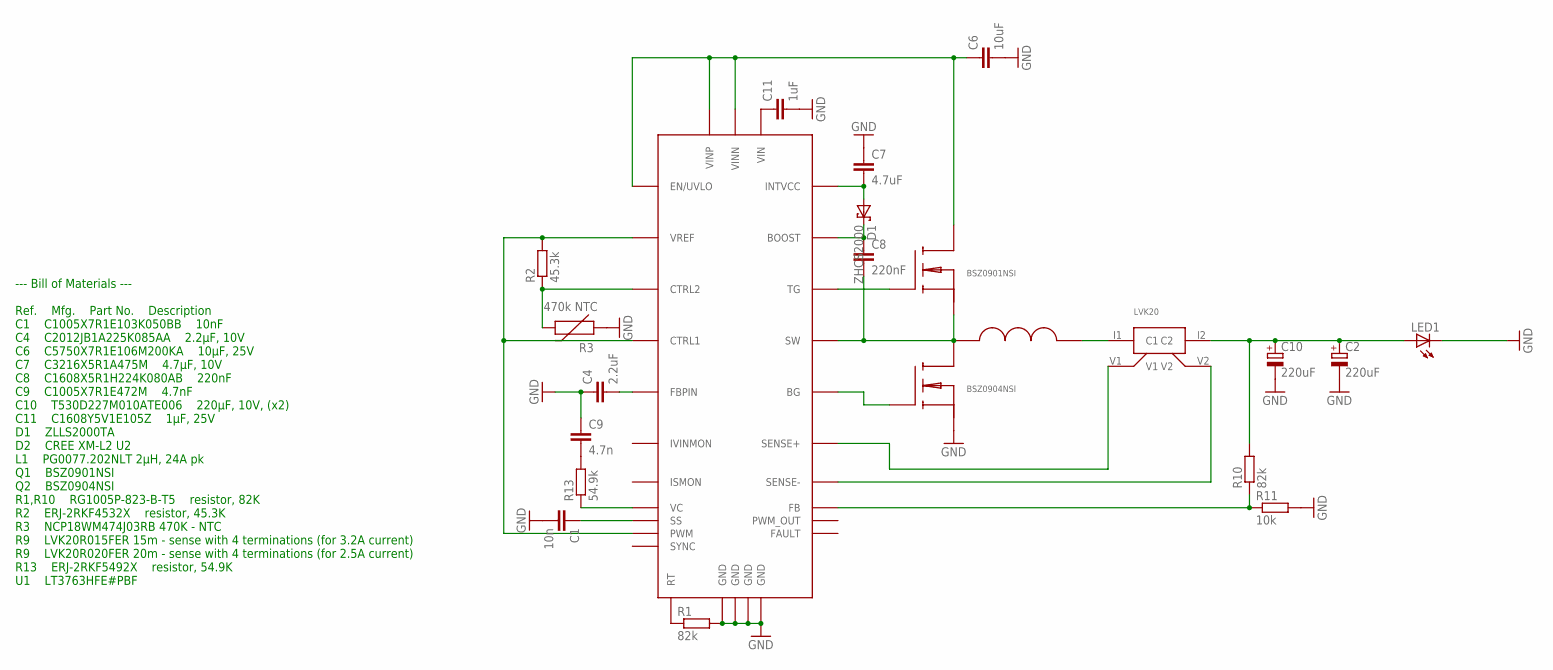
[picture p27: schematic led_driver_3A.sch]

Parts:
C1: 10n; C0402
C2, C10: 220uF; SMC_D
C4: 2.2uF; C0805
C6: 10uF; C2220K
C7: 4.7uF; C1206
C8: 220nF; C0603
C9: 4.7n; C0402
C11: 1uF; C0603
D1: ZHCS2000; SOT23-6
LED1: LEDSIDELED; OSRAM-SIDELED
R1, R10: 82k; R0402
R2: 45.3k; R0402
R3: 470k NTC; 0603
R11: 10k; R0402
R13: 54.9k; R0402
U$1: LT3763; TSSOP-28
U$2: PG0077
U$3: BSZ0901NSI; BSZ090X
U$4: BSZ0904NSI; BSZ090X
U$5: LVK20

Connections:
GND: C1.2, C2.-, C4.1, C6.2, C7.1, C9.1, C10.-, C11.2, LED1.C, R1.2, R3.1, R11.2, U$1.P$12 (GND), U$1.P$23 (GND), U$1.P$28 (GND), U$1.TH (GND), U$4.S@1 (S), U$4.S@2 (S), U$4.S@3 (S), U$4.S@4 (S)
unnamed: C11.1, U$1.P$3 (VIN)
unnamed: C7.2, D1.3 (A), D1.4 (A), U$1.P$2 (INTVCC)
unnamed: C9.2, R13.2
unnamed: R2.1, R3.2, U$1.P$13 (CTRL2)
unnamed: C2.+, C10.+, LED1.A, R10.2, U$5.I2 (C2)
unnamed: R1.1, U$1.P$20 (RT)
unnamed: R10.1, R11.1, U$1.P$11 (FB)
unnamed: C1.1, U$1.P$15 (SS)
unnamed: R13.1, U$1.P$18 (VC)
unnamed: C4.2, U$1.P$10 (FBPIN)
unnamed: R2.2, U$1.P$5 (VREF), U$1.P$14 (CTRL1), U$1.P$22 (PWM)
unnamed: C8.1, D1.1 (K), D1.2 (K), D1.5 (K), D1.6 (K), U$1.P$27 (BOOST)
unnamed: C8.2, U$1.P$26 (SW), U$2.P$1, U$3.S@1 (S), U$3.S@2 (S), U$3.S@3 (S), U$3.S@4 (S), U$4.D, U$4.D@1 (D), U$4.D@2 (D), U$4.D@3 (D), U$4.D@4 (D)
unnamed: U$1.P$25 (TG), U$3.G
unnamed: U$1.P$1 (BG), U$4.G
unnamed: U$1.P$17 (SENSE+), U$5.V1
unnamed: U$1.P$16 (SENSE-), U$5.V2
unnamed: U$2.P$2, U$5.I1 (C1)
VIN: C6.1, U$1.P$4 (EN/UVLO), U$1.P$6 (VINN), U$1.P$7 (VINP), U$3.D, U$3.D@1 (D), U$3.D@2 (D), U$3.D@3 (D), U$3.D@4 (D)

Notes on the sheet:
--- Bill of Materials --- Ref. Mfg. Part No. Description C1 C1005X7R1E103K050BB 10nF C4 C2012JB1A225K085AA 2.2µF, 10V C6 C5750X7R1E106M200KA 10µF, 25V C7 C3216X5R1A475M 4.7µF, 10V C8 C1608X5R1H224K080AB 220nF C9 C1005X7R1E472M 4.7nF C10 T530D227M010ATE006 220µF, 10V, (x2) C11 C1608Y5V1E105Z 1µF, 25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

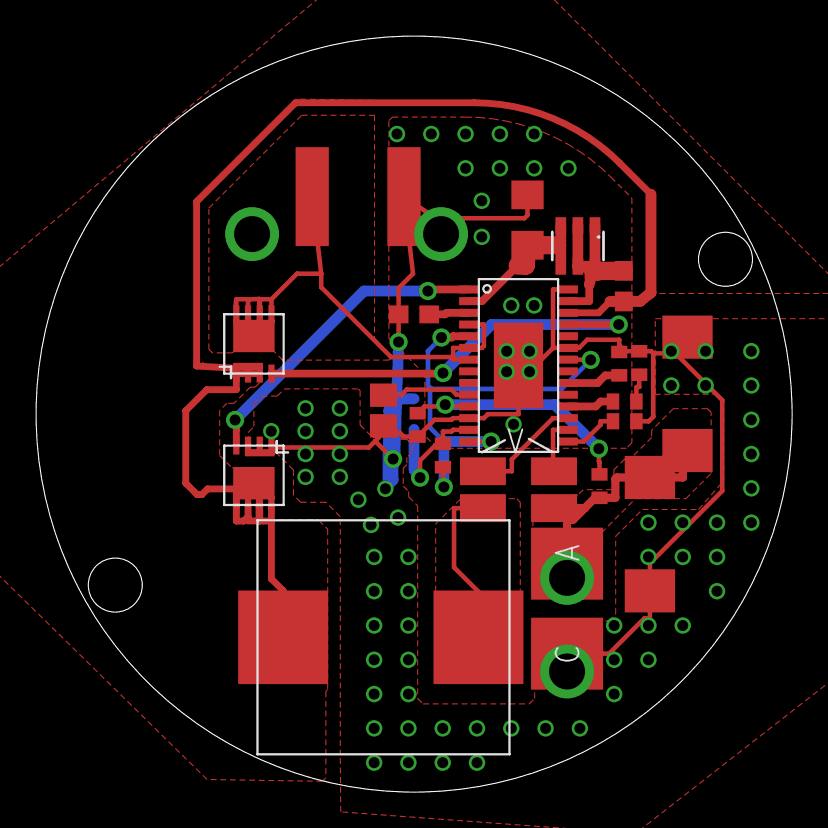
[picture p28: board led_driver_3A.brd from above]

Board: 2 copper layers, 42.0 x 42.0 mm, 22 parts (1 on the bottom side), 20 nets.
