dmitryshagin/flashlight/button_control/control.brd

## EAGLE design button_control/control.brd (2015-12-27)

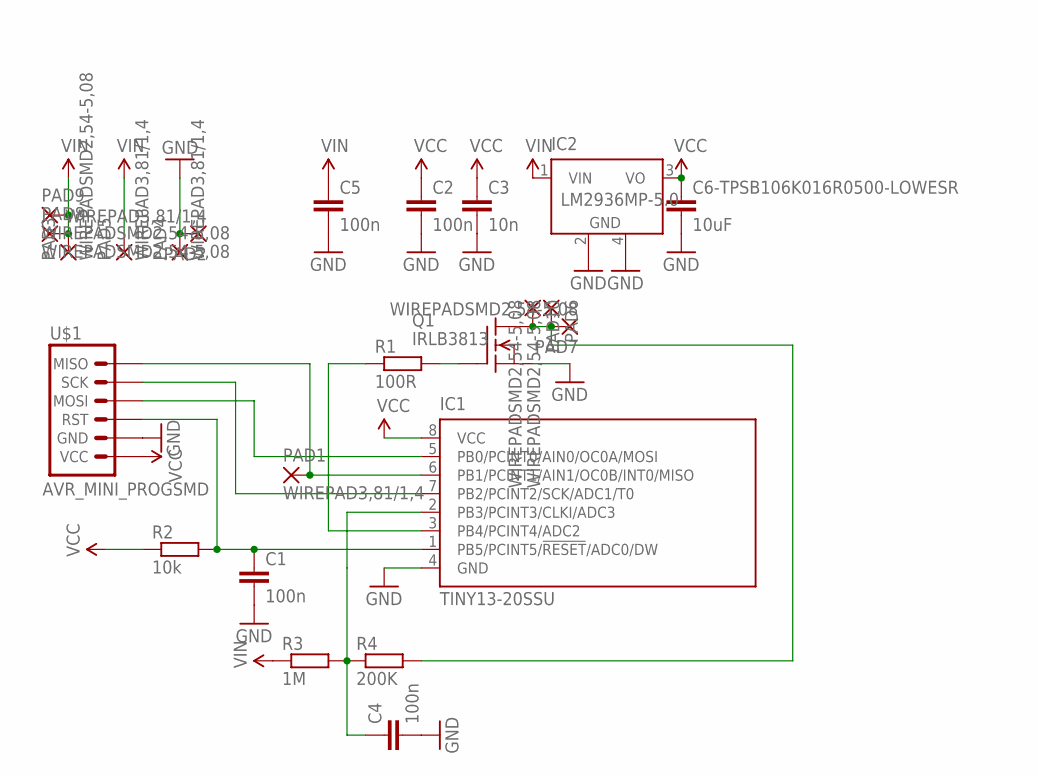
[picture p29: schematic control.sch]

Parts:
C1: 100n; 1210
C2, C4, C5: 100n; 1206
C3: 10n; 1206
C6-TPSB106K016R0500-LOWESR: 10uF; C1210
IC1: TINY13-20SSU; 8S1
IC2: LM2936MP-5.0; SOT223
PAD1, PAD2, PAD4, PAD5: WIREPAD3,81/1,4; 3,81/1,4
PAD3, PAD6, PAD7, PAD8, PAD9, PAD10: WIREPADSMD2,54-5,08; SMD2,54-5,08
Q1: IRLB3813; TO220
R1: 100R; M1206
R2: 10k; R1206
R3: 1M; M1206
R4: 200K; M1206
U$1: AVR_MINI_PROGSMD; AVR_MINI_PROG

Connections:
GND: C1.2, C2.2, C3.2, C4.2, C5.2, C6-TPSB106K016R0500-LOWESR.2, IC1.4 (GND), IC2.2 (GND), IC2.4 (GND), PAD2.1, PAD4.1, Q1.3 (S), U$1.2 (GND)
unnamed: IC1.6 (PB1/PCINT1/AIN1/OC0B/INT0/MISO), PAD1.1, U$1.6 (MISO)
unnamed: IC1.5 (PB0/PCINT0/AIN0/OC0A/MOSI), U$1.4 (MOSI)
unnamed: IC1.7 (PB2/PCINT2/SCK/ADC1/T0), U$1.5 (SCK)
unnamed: C1.1, IC1.1 (PB5/PCINT5/!RESET!/ADC0/DW), R2.2, U$1.3 (RST)
unnamed: Q1.1 (G), R1.2
unnamed: IC1.3 (PB4/PCINT4/ADC2), R1.1
unnamed: PAD6.1, PAD7.1, PAD10.1, Q1.2 (D), R4.2
unnamed: C4.1, IC1.2 (PB3/PCINT3/CLKI/ADC3), R3.2, R4.1
VCC: C2.1, C3.1, C6-TPSB106K016R0500-LOWESR.1, IC1.8 (VCC), IC2.3 (VO), R2.1, U$1.1 (VCC)
VIN: C5.1, IC2.1 (VIN), PAD3.1, PAD5.1, PAD8.1, PAD9.1, R3.1

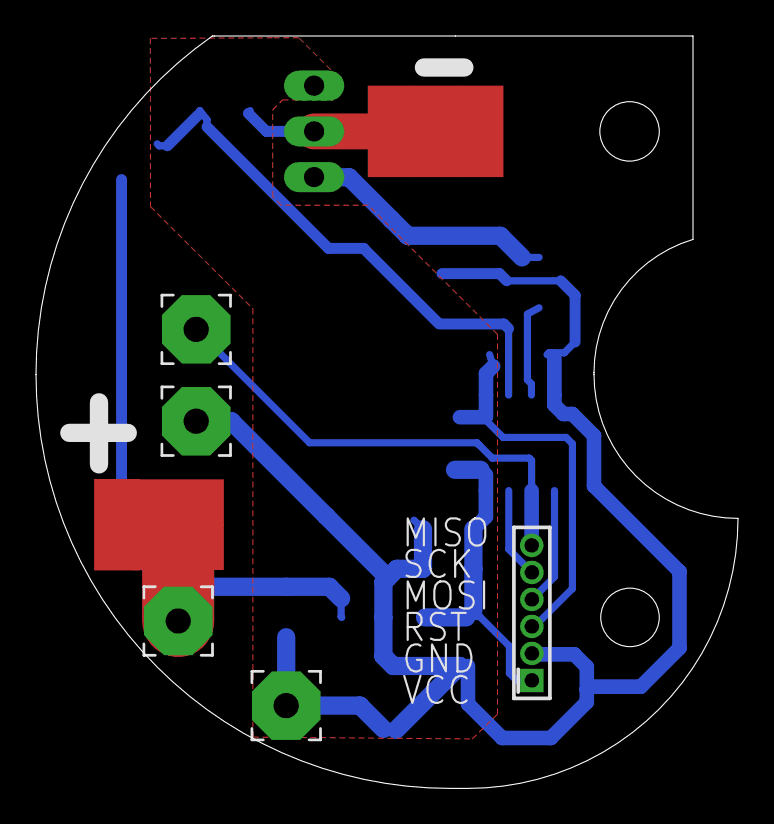
[picture p30: board control.brd from above]

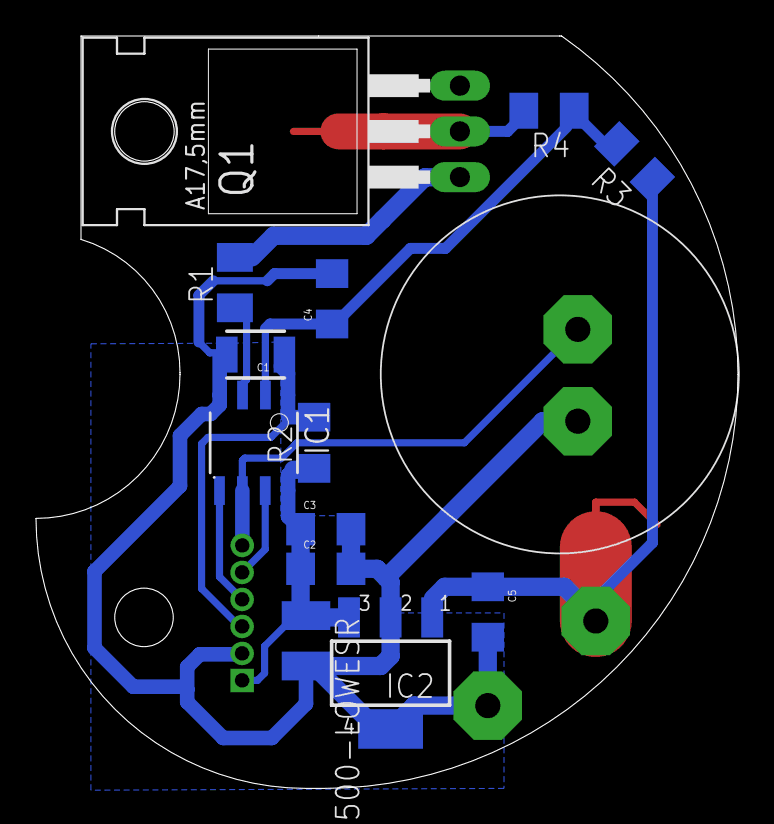
[picture p31: board control.brd from below]

Board: 2 copper layers, 39.0 x 41.8 mm, 24 parts (13 on the bottom side), 11 nets.
