dmitryshagin/flashlight/button_control_small/btnsm.brd

## EAGLE design button_control_small/btnsm.brd (2018-02-25)

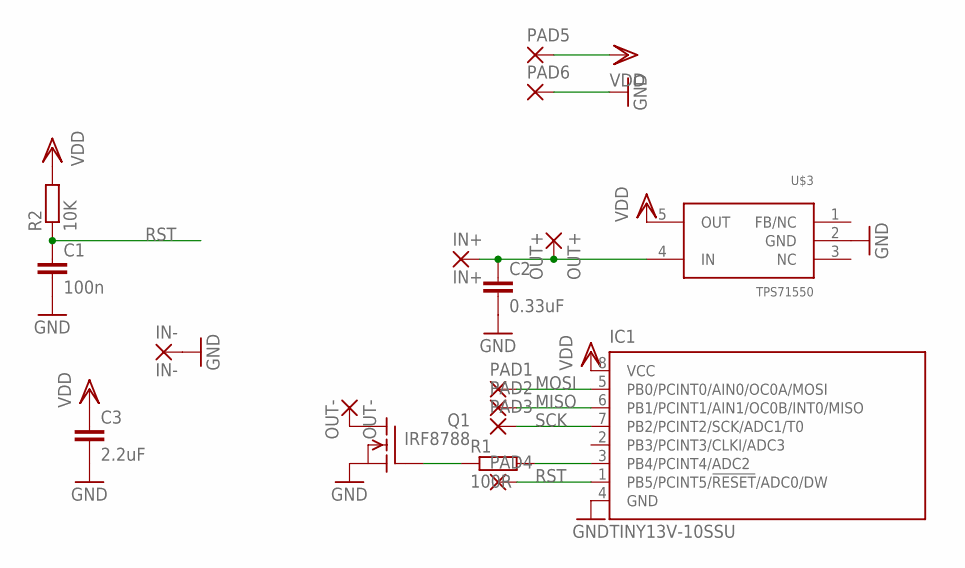
[picture p32: schematic btnsm.sch]

Parts:
C1: 100n; C0603
C2: 0.33uF; C0603
C3: 2.2uF; C0603
IC1: TINY13V-10SSU; 8S1
IN+: IN+; SMD2,54-5,08
IN-: IN-; SMD2,54-5,08
OUT+: OUT+; SMD2,54-5,08
OUT-: OUT-; SMD2,54-5,08
PAD1, PAD2, PAD3, PAD4, PAD5, PAD6: 1,6/0,9
Q1: IRF8788; SO-8
R1: 100R; R0402
R2: 10K; R0402
U$3: TPS71550; SC70

Connections:
GND: C1.2, C2.2, C3.2, IC1.4 (GND), IN-.1, PAD6.1, Q1.1 (S), Q1.2 (S), Q1.3 (S), U$3.2 (GND)
MISO: IC1.6 (PB1/PCINT1/AIN1/OC0B/INT0/MISO), PAD2.1
MOSI: IC1.5 (PB0/PCINT0/AIN0/OC0A/MOSI), PAD1.1
unnamed: IC1.3 (PB4/PCINT4/ADC2), R1.2
unnamed: Q1.4 (G), R1.1
unnamed: C2.1, IN+.1, OUT+.1, U$3.4 (IN)
unnamed: OUT-.1, Q1.5 (D), Q1.6 (D), Q1.7 (D), Q1.8 (D)
RST: C1.1, IC1.1 (PB5/PCINT5/!RESET!/ADC0/DW), PAD4.1, R2.1
SCK: IC1.7 (PB2/PCINT2/SCK/ADC1/T0), PAD3.1
VDD: C3.1, IC1.8 (VCC), PAD5.1, R2.2, U$3.5 (OUT)

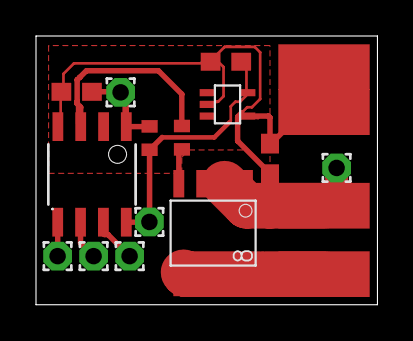
[picture p33: board btnsm.brd from above]

Board: 2 copper layers, 19.0 x 14.9 mm, 18 parts (0 on the bottom side), 10 nets.
