dmitryshagin/flashlight/button_control_small/btnsm_a_bit_larger.brd

## EAGLE design button_control_small/btnsm_a_bit_larger.brd (2018-05-29)

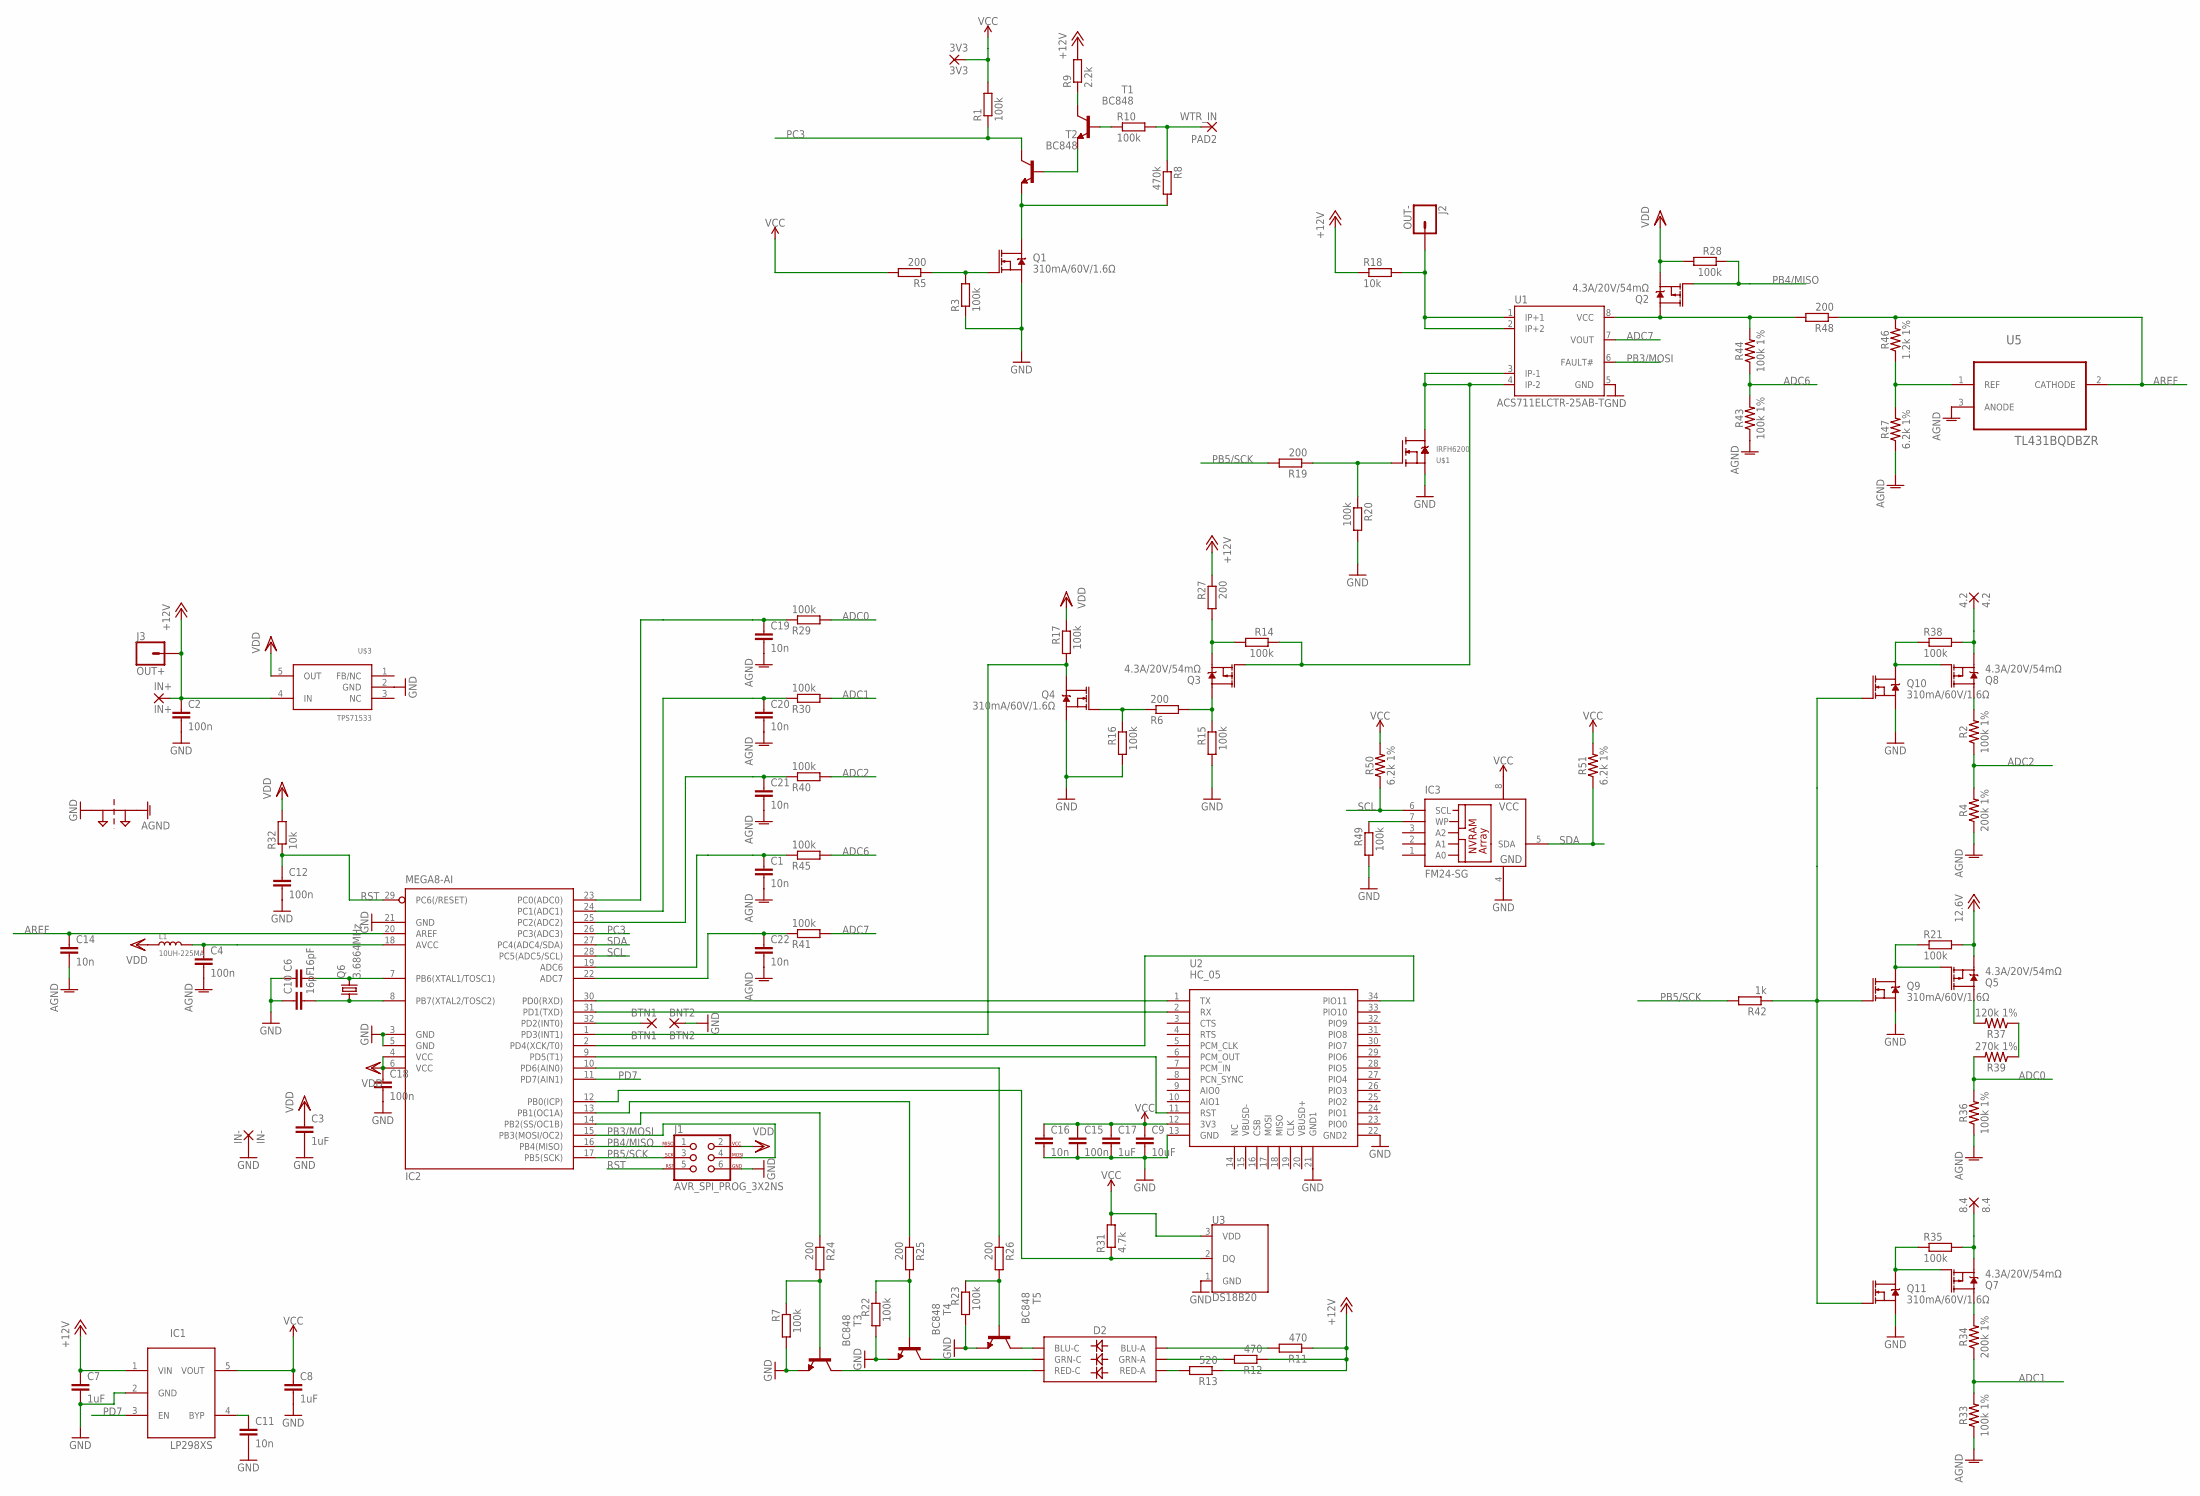
[picture p34: schematic btnsm_a_bit_larger.sch]

Parts:
3V3: 3V3; SMD1,27-2,54
4.2: 4.2; SMD1,27-2,54
8.4: 8.4; SMD1,27-2,54
BTN1: BTN1; 1,6/0,9
BTN2: BNT2; 1,6/0,9
C1, C11, C14, C16, C19, C20, C21, C22: 10n; C0402
C2: 100n; C0603
C3, C7, C8, C17: 1uF; C0805
C4, C12, C15, C18: 100n; C0402
C6, C10: 16pF; C0402
C9: 10uF; C0805
D2: LED-RGBNO_IC; LED-TRICOLOR-5050
IC1: LP298XS; SOT23-5L
IC2: MEGA8-AI; TQFP32-08
IC3: FM24-SG; SO8
IN+: IN+; SMD2,54-5,08
IN-: IN-; SMD2,54-5,08
J1: AVR_SPI_PROG_3X2NS; 2X3-NS
J2: OUT-; 1X01_2MM
J3: OUT+; 1X01_2MM
L1: 10UH-225MA; L0806
PAD2: WTR_IN; SMD1,27-2,54
Q1, Q4, Q9, Q10, Q11: 310mA/60V/1.6Ω; SOT323
Q2, Q3, Q5, Q7, Q8: 4.3A/20V/54mΩ; SOT23-3
Q6: 3.6864MHz; HC49/S
R1, R3, R7, R10, R14, R15, R16, R17, R20, R21, R22, R23, R28, R29, R30, R35, R38, R40, R41, R45, R49: 100k; R0402
R2, R33, R36, R43, R44: 100k 1%; 0805
R4, R34: 200k 1%; 0805
R5, R6, R19, R24, R25, R26, R27, R48: 200; R0402
R8: 470k; R0402
R9: 2.2k; R0402
R11, R12: 470; R0805
R13: 520; R0805
R18, R32: 10k; R0402
R31: 4.7k; R0402
R37: 120k 1%; 0805
R39: 270k 1%; 0805
R42: 1k; R0402
R46: 1.2k 1%; 0805
R47, R50, R51: 6.2k 1%; 0805
SUPPLY7: 2PT_GND_TIE
T1, T2, T3, T4, T5: BC848; SOT23
U1: ACS711ELCTR-25AB-T; SOIC8
U2: HC_05; BLUETOOTH_SMD
U3: DS18B20; TO-92-AMMO
U5: TL431BQDBZR; SOT95P237X112-3N
U$1: IRFH6200; PQFN
U$3: TPS71533; SC70

Connections:
+12V: C2.1, C7.1, IC1.1 (VIN), IN+.1, J3.1, Q5.2 (S), R9.2, R11.1, R12.1, R13.1, R18.1, R21.2, R27.1, U$3.4 (IN)
ADC0: R29.2, R36.2, R39.2
ADC1: R30.2, R33.2, R34.1
ADC2: R2.1, R4.2, R40.2
ADC6: R43.2, R44.1, R45.2
ADC7: R41.2, U1.7 (VOUT)
AGND: C1.2, C4.2, C14.2, C19.2, C20.2, C21.2, C22.2, R4.1, R33.1, R36.1, R43.1, R47.1, SUPPLY7.P$2, U5.3 (ANODE)
AREF: C14.1, IC2.20 (AREF), R46.2, R48.1, U5.2 (CATHODE)
AVCC: C4.1, IC2.18 (AVCC), L1.2
B+: D2.3 (BLU-A), R11.2
B-: D2.4 (BLU-C), T5.3 (C)
B-BASE: R23.1, R26.2, T5.1 (B)
BTN1: BTN1.1, IC2.32 (PD2(INT0))
G+: D2.1 (GRN-A), R12.2
G-: D2.6 (GRN-C), T4.3 (C)
G-BASE: R22.1, R25.2, T4.1 (B)
GND: BTN2.1, C2.2, C3.2, C6.1, C7.2, C8.2, C9.2, C10.1, C11.2, C12.2, C15.2, C16.2, C17.2, C18.2, IC1.2 (GND), IC2.3 (GND), IC2.5 (GND), IC2.21 (GND), IC3.4 (GND), IN-.1, J1.6, Q1.2 (S), Q4.2 (S), Q9.2 (S), Q10.2 (S), Q11.2 (S), R3.1, R7.2, R15.2, R16.2, R20.2, R22.2, R23.2, R49.2, SUPPLY7.P$1, T3.2 (E), T4.2 (E), T5.2 (E), U1.5 (GND), U2.13 (GND), U2.21 (GND1), U2.22 (GND2), U3.1 (GND), U$1.1 (S), U$1.2 (S), U$1.3 (S), U$3.2 (GND)
GND_OUT: J2.1, R18.2, U1.1 (IP+1), U1.2 (IP+2)
GND_OUT_MEASURE: Q3.1 (G), R14.1, U1.3 (IP-1), U1.4 (IP-2), U$1.5 (D), U$1.6 (D), U$1.7 (D), U$1.8 (D), U$1.9 (D)
unnamed: Q4.1 (G), R6.1, R16.1
unnamed: C11.1, IC1.4 (BYP)
unnamed: Q7.1 (G), Q11.3 (D), R35.1
unnamed: Q1.3 (D), R8.2, T2.2 (E)
unnamed: Q7.3 (D), R34.2
unnamed: Q8.1 (G), Q10.3 (D), R38.1
unnamed: Q8.3 (D), R2.2
unnamed: R37.1, R39.1
unnamed: Q3.3 (D), R6.2, R15.1
unnamed: 8.4.1, Q7.2 (S), R35.2
unnamed: Q5.1 (G), Q9.3 (D), R21.1
unnamed: 4.2.1, Q8.2 (S), R38.2
unnamed: T1.2 (E), T2.1 (B)
unnamed: Q2.3 (D), R44.2, R48.2, U1.8 (VCC)
unnamed: R10.1, T1.1 (B)
unnamed: Q9.1 (G), Q10.1 (G), Q11.1 (G), R42.1
unnamed: Q5.3 (D), R37.2
unnamed: IC3.7 (WP), R49.1
unnamed: Q3.2 (S), R14.2, R27.2
OUT_BASE: R19.1, R20.1, U$1.4 (G)
PB0: IC2.12 (PB0(ICP)), R31.1, U3.2 (DQ)
PB1: IC2.13 (PB1(OC1A)), R25.1
PB2: IC2.14 (PB2(SS/OC1B)), R24.1
PB3/MOSI: IC2.15 (PB3(MOSI/OC2)), J1.4, U1.6 (FAULT#)
PB4/MISO: IC2.16 (PB4(MISO)), J1.1, Q2.1 (G), R28.1
PB5/SCK: IC2.17 (PB5(SCK)), J1.3, R19.2, R42.2
PB6: C6.2, IC2.7 (PB6(XTAL1/TOSC1)), Q6.2
PB7: C10.2, IC2.8 (PB7(XTAL2/TOSC2)), Q6.1
PC3: IC2.26 (PC3(ADC3)), R1.1, T2.3 (C)
PD3: IC2.1 (PD3(INT1)), Q4.3 (D), R17.2
PD4-HC05_KEY: IC2.2 (PD4(XCK/T0)), U2.34 (PIO11)
PD5-HC05_RST: IC2.9 (PD5(T1)), U2.11 (RST)
PD6(PWM0): IC2.10 (PD6(AIN0)), R26.1
PD7: IC1.3 (EN), IC2.11 (PD7(AIN1))
R+: D2.2 (RED-A), R13.2
R-: D2.5 (RED-C), T3.3 (C)
R-BASE: R7.1, R24.2, T3.1 (B)
REF: R46.1, R47.2, U5.1 (REF)
RST: C12.1, IC2.29 (PC6(/RESET)), J1.5, R32.1
RX(UC): IC2.30 (PD0(RXD)), U2.1 (TX)
SCL: IC2.28 (PC5(ADC5/SCL)), IC3.6 (SCL), R50.1
SDA: IC2.27 (PC4(ADC4/SDA)), IC3.5 (SDA), R51.1
TX(UC): IC2.31 (PD1(TXD)), U2.2 (RX)
VCC: 3V3.1, C8.1, C9.1, C15.1, C16.1, C17.1, IC1.5 (VOUT), IC3.8 (VCC), R1.2, R5.2, R31.2, R50.2, R51.2, U2.12 (3V3), U3.3 (VDD)
VDD: C3.1, C18.1, IC2.4 (VCC), IC2.6 (VCC), J1.2, L1.1, Q2.2 (S), R17.1, R28.2, R32.2, U$3.5 (OUT)
WTR-IN: PAD2.1, R8.1, R10.2
WTR_MEASURE_ON: Q1.1 (G), R3.2, R5.1
WTR_MEASURE_PULLUP: R9.1, T1.3 (C)
_A0: C19.1, IC2.23 (PC0(ADC0)), R29.1
_A1: C20.1, IC2.24 (PC1(ADC1)), R30.1
_A2: C21.1, IC2.25 (PC2(ADC2)), R40.1
_A6: C1.1, IC2.19 (ADC6), R45.1
_A7: C22.1, IC2.22 (ADC7), R41.1

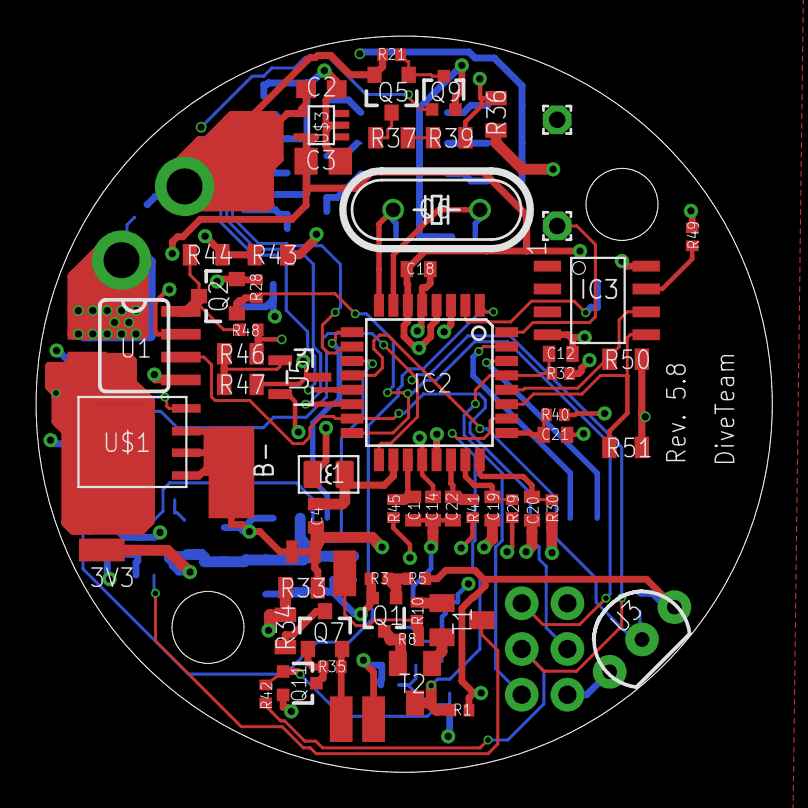
[picture p35: board btnsm_a_bit_larger.brd from above]

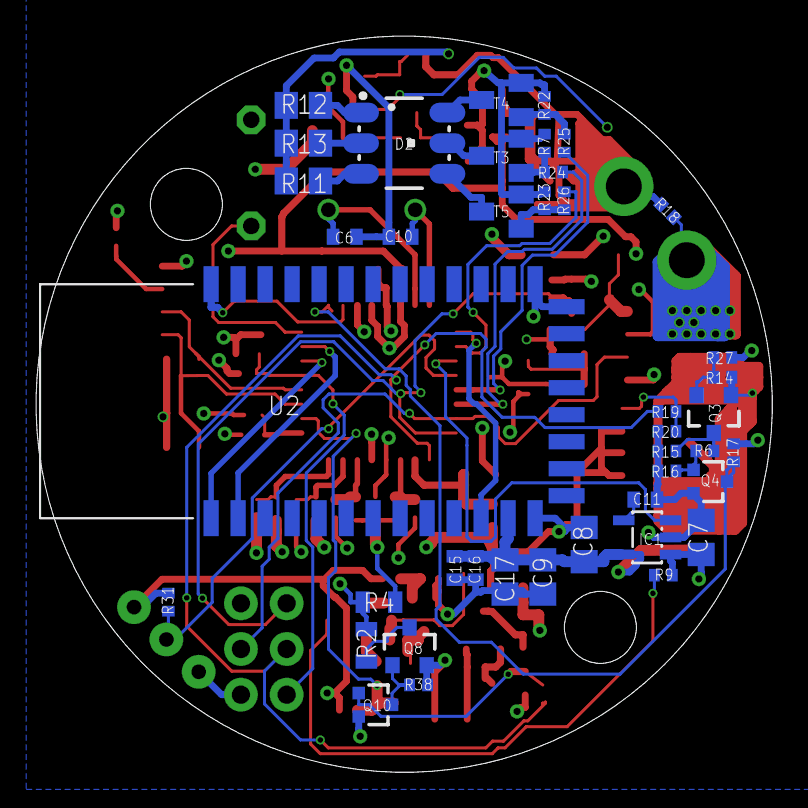
[picture p36: board btnsm_a_bit_larger.brd from below]

Board: 4 copper layers, 40.9 x 40.9 mm, 110 parts (42 on the bottom side), 72 nets.
