dmitryshagin/flashlight/canister/main.c

#include <avr/io.h>
#include <avr/eeprom.h>
#include <avr/interrupt.h>
#include <stdio.h>
#include <avr/sleep.h>
#include <avr/wdt.h>
#include <util/delay.h>
#include "init.h"
#include "adc.h"
#include "uart.h"
#include "uart_proto.h"
#include "i2c.h"

//910 - 12.230V
// 1 LSB ADC ~= 0,01343956044V
//10V - 744 ADC
//10.8V - 804 ADC
#define LOW_LIMIT 744
#define MEDIUM_LIMIT 804
#define HYSTERESIS 2


void process_LED(){
	if( is_on ){ //Is output on?
		if(is_leaking){
			int8_t blinker = (global_counter % 0x20) - 0xF;
			uint8_t val = 0;
			if(blinker < 0){
				val = 0xFF - blinker * 0xF;
			}else{
				val = blinker * 0xF;
			}
			set_LED(val,0,0);
		}else{
			if(is_charging){
				int8_t blinker = ((global_counter / 5) % 0x20) - 0xF;
				uint8_t val = 0;
				if(blinker < 0){
					val = 0xFF - blinker * 0xF;
				}else{
					val = blinker * 0xF;
				}
				set_LED(0,0,val/2); //not too bright
			}else{
				if(adc_values[0] < LOW_LIMIT){
					set_LED(0xFF,0,0);
				}else if(adc_values[0] > (LOW_LIMIT + HYSTERESIS) &&
				   		 adc_values[0] < MEDIUM_LIMIT){
					set_LED(0,0,0xFF);
				}else if(adc_values[0] > (MEDIUM_LIMIT + HYSTERESIS)){
					set_LED(0,0xFF,0);
				}

				//just started app and hit inside hysteresis value
				if(OCR1B == 0 && OCR1A == 0 && OCR0A == 0xFF){
					if(adc_values[0] < LOW_LIMIT){
						set_LED(0xFF,0,0);
					}else if(adc_values[0] < MEDIUM_LIMIT){
						set_LED(0,0,0xFF);
					}else{
						set_LED(0,0xFF,0);
					}					
				}
			}
		}
	}else{
		set_LED(0,0,0);
	}
}

void process_state(){
	if(!interrupt_triggered){
		while(!(PIND & (1<<PIND2))){_delay_ms(1);}
		EIMSK |= (1<<0);
	}
	if(interrupt_triggered || should_on){
		if(is_on){
			while(!(PIND & (1<<PIND2)) && button_pressed_for < 50){
				button_pressed_for +=1;
				_delay_ms(1);
			}
			if(button_pressed_for > 25){
				turn_off();
			}
		}
		if(!is_on){ //do not set ELSE here - it will work WRONG after interrupt
			while(!(PIND & (1<<PIND2)) && button_pressed_for < 50){
				button_pressed_for +=1;
				_delay_ms(1);
			}
			if(button_pressed_for > 25 || should_on){
				turn_on();
			}
		}
		interrupt_triggered = 0;
		should_on = 0;
	}

	if(is_on){
		if(!(PINB & (1<<PB3))){ //Emergency condition - overcurrent!
			// _delay_ms(100);
			// if(!(PINB & (1<<PB3))){
				// turn_off();
			// }
		}
	}
}

uint32_t compress_data_for_fram(){
	//first 10 bits - voltage (ADC0)
	//second 10 bits - current (reference adc - current adc)
	//next 11 bits - temperature * 16
	//last bit - leakage
	uint32_t current;
	if(adc_values[3] + 512 < adc_values[4]){
		current = 0;
	}else{
		current = (adc_values[3] + 512 - adc_values[4]);
	}
	return (((uint32_t)adc_values[0] & 0x3FF) << 22) |
		   ((current & 0x3FF) << 12) |
		   (((temperature & 0xFFF) >> 1) << 1) |
		   (is_leaking & 0x1);
}

int main(void){
	init();
	fram_position = eeprom_read_word((uint8_t*)0);
	if(fram_position > 0x1FF){
		fram_position = 0;
	}

	set_sleep_mode(SLEEP_MODE_PWR_DOWN);
	should_on = 1;
	sei();

	for(;;){
		if(!wanna_reboot){
			wdt_reset();
			process_state();
			process_leakage();
			process_uart();
			get_adc();
			process_adc();
			process_temperature();
			if(adc_ready){
				process_LED();
			}
			
			if(last_processed_counter != global_counter){
				//once a minute
				if(global_counter - last_stored_at > 6000){
					fram_write(fram_position, compress_data_for_fram());

					fram_position++;
					if(fram_position > 0x1FF){
						fram_position = 0;
					}
					last_stored_at = global_counter;
				}
				last_processed_counter = global_counter;
			}
		}
	};
	return 0;	
}
