dmitryshagin/flashlight/canister/i2c.h

/*
 * File:   i2c.h
 * Author: Christopher Kruczek
 *
 * Created on December 9, 2015, 7:50 AM
 */

#ifndef I2C_H
#define I2C_H

#include <avr/io.h>
#include <util/twi.h>
#include <avr/interrupt.h>

#include <stdint.h>
#include <stdio.h>

#define F_SCL 100000UL // SCL frequency

#define I2C_READ    TW_READ
#define I2C_WRITE   TW_WRITE


extern void i2c_init();
extern uint8_t i2c_start(uint8_t address, uint8_t mode);
extern uint8_t i2c_write(uint8_t data);
extern uint8_t i2c_read_ack();
extern uint8_t i2c_read_nack();
extern uint8_t i2c_stop();

extern void fram_write(uint16_t address, uint32_t data);
extern uint32_t fram_read(uint16_t address);

#endif
