dmitryshagin/flashlight/canister/bootloader/mega168.h

#ifndef _MEGA168_H_
#define _MEGA168_H_

/* Part-Code ISP - make it look like M16 */
#define DEVTYPE_ISP     0x74
/* Part-Code Boot - make it look like M16 */
#define DEVTYPE_BOOT    0x75

#define SIG_BYTE1	0x1E
#define SIG_BYTE2	0x94
#define SIG_BYTE3	0x0B

#define UART_BAUD_HIGH	UBRR0H
#define UART_BAUD_LOW	UBRR0L
#define UART_STATUS	UCSR0A
#define UART_TXREADY	UDRE0
#define UART_RXREADY	RXC0
#define UART_DOUBLE	U2X
#define UART_CTRL	UCSR0B
#define UART_CTRL_DATA	((1<<TXEN0) | (1<<RXEN0))
#define UART_CTRL2	UCSR0C
#define UART_CTRL2_DATA	((1<<UCSZ01) | (1<<UCSZ00))
#define UART_DATA	UDR0


// #define UART0_UDRIE    UDRIE0


#endif // #ifndef _MEGA16_H_
