dmitryshagin/flashlight/(commit log)

2015-12-27 pushing flashlight project to public
    [Head.3dm, control.brd, control.dsn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]
2015-12-27 comments translated for pwm controller
2016-02-06 fixed adc restore
2017-07-10 Added tiny board for piezo button control
    [btnsm.GBL, btnsm.GBO, btnsm.GBP, btnsm.GBS, btnsm.GTL, btnsm.GTO, btnsm.GTP, btnsm.GTS]
2017-09-01 Added version for heater canister
    [btnsm_a_bit_larger.brd, btnsm_a_bit_larger.sch]
2017-12-18 Add files via upload
    Developing a new version with better power consumption and capabilities
    [btnsm_a_bit_larger.brd, btnsm_a_bit_larger.sch]
2017-12-19 Routed version with BT module
    [btnsm_a_bit_larger.brd, btnsm_a_bit_larger.sch]
2018-01-28 Switched to HC-05
    Added protection for water-input
    Added separate power supply for BT & DS18B20
    Added DS18B20
    [btnsm_a_bit_larger.brd, btnsm_a_bit_larger.sch]
2018-02-17 Removed extra route, slight changes to ground poly
    [btnsm_a_bit_larger.brd]
2018-02-17 Removed extra wire
    [btnsm_a_bit_larger.sch]
2018-02-22 Adding low-level. Added LED & ADC.
    [control.dsn, led_driver_3A.dsn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]
2018-02-25 Switched to async ds18b20
2018-03-04 Changes led color, added some global statuses
2018-03-20 Added FRAM and extra capacitors
    [btnsm_a_bit_larger.brd, btnsm_a_bit_larger.sch]
2018-04-07 Added extra ADC channels, filters to ADC & AREF
    Switched to 4 layers board in order to have proper AGND and shield ADC channels from any noise.
    [btnsm_a_bit_larger.sch]
2018-05-29 Switched to a new hardware
2018-05-29 Bump to 5.8
    [btnsm_a_bit_larger.brd, btnsm_a_bit_larger.sch]
2018-08-26 Added initial BT confix, fixed power drain on powerdown
    [adc.c, globals.c, globals.h, init.c, init.h, main.c, uart.c, uart.h]
2018-11-04 Remove pullup from BT Reset on powerdown to reduce current consumption
    [init.c]
2018-11-19 debugging rapid turn off. v01
    [Head.3dm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]
2018-12-16 Added WDT & leakage recording
    [globals.c, globals.h, init.c, main.c, uart_proto.c]
2018-12-16 Added UART timeout, fixed temperature output
    [globals.c, globals.h, main.c, uart_proto.c]
2018-12-25 Changes interrupts logics
2018-12-25 Interrupts rework
2018-12-25 Fixed double tap for turn on
    [init.c, main.c, uart_proto.c]
2019-01-24 Adding esp32 version
    [button_control_esp32.brd, button_control_esp32.sch]
2019-04-28 added delay to avoid pantom switching
    [globals.c, globals.h, init.c, main.c]
